triwebb1/crackle/data/audio/fan-calibration-2026-07-25/analysis/esp-8.9-spectrogram.png

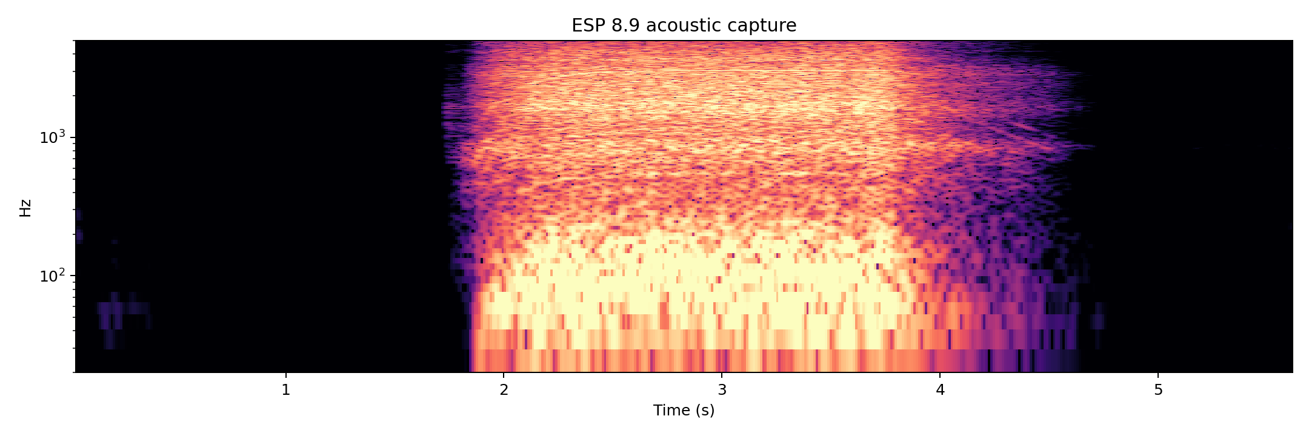
data/audio/fan-calibration-2026-07-25/analysis/esp-8.9-spectrogram.png
