triwebb1/crackle/data/audio/fan-calibration-2026-07-25/analysis/spectrograms.png

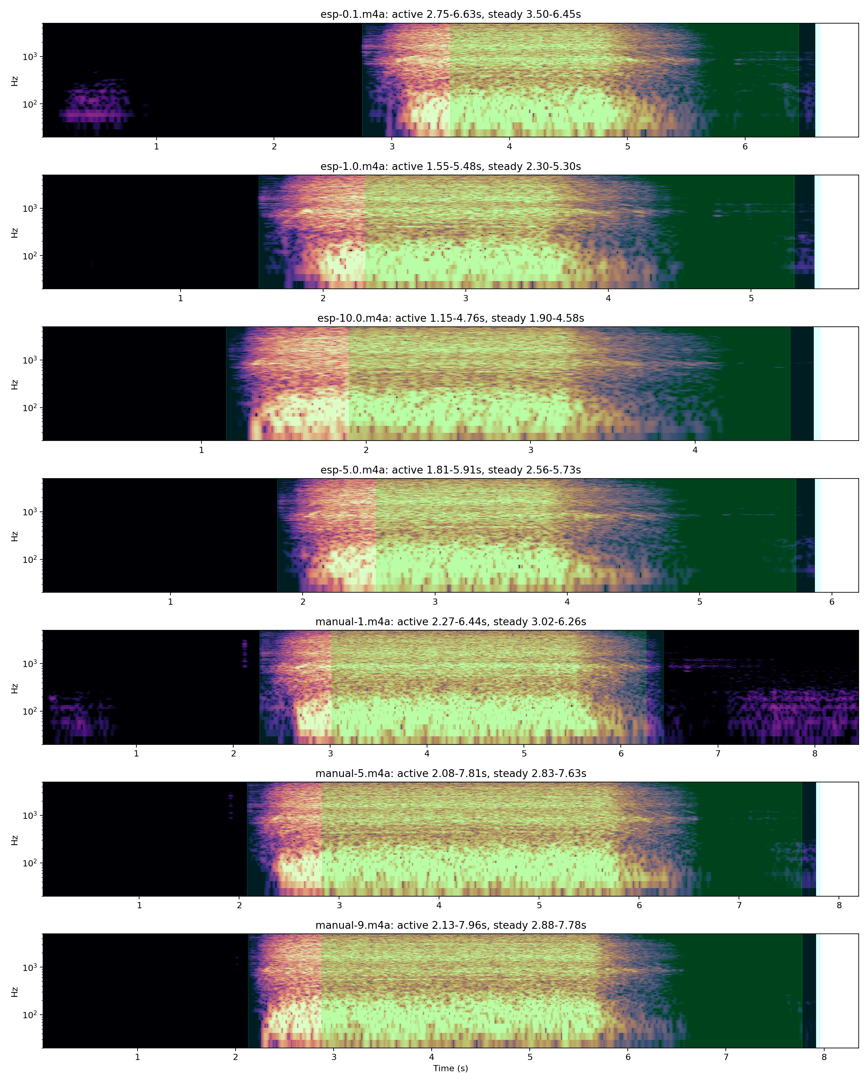
data/audio/fan-calibration-2026-07-25/analysis/spectrograms.png
