triwebb1/crackle/data/audio/fan-calibration-2026-07-25/analysis/fan-tone-calibration.png

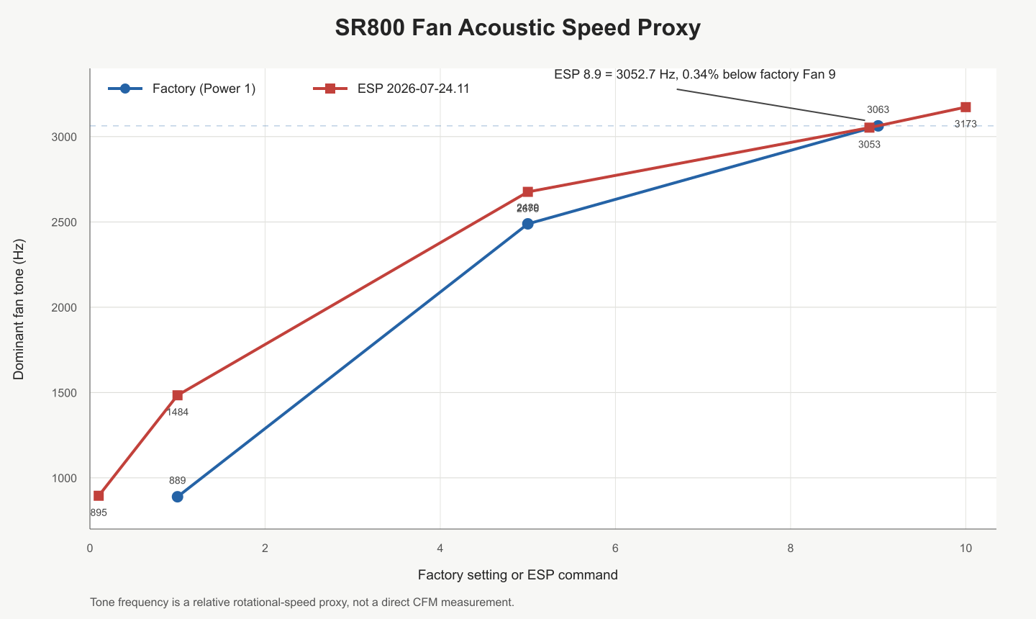
data/audio/fan-calibration-2026-07-25/analysis/fan-tone-calibration.png
