triwebb1/crackle/data/audio/fan-calibration-2026-07-25/analysis/steady-psd-overlays.png

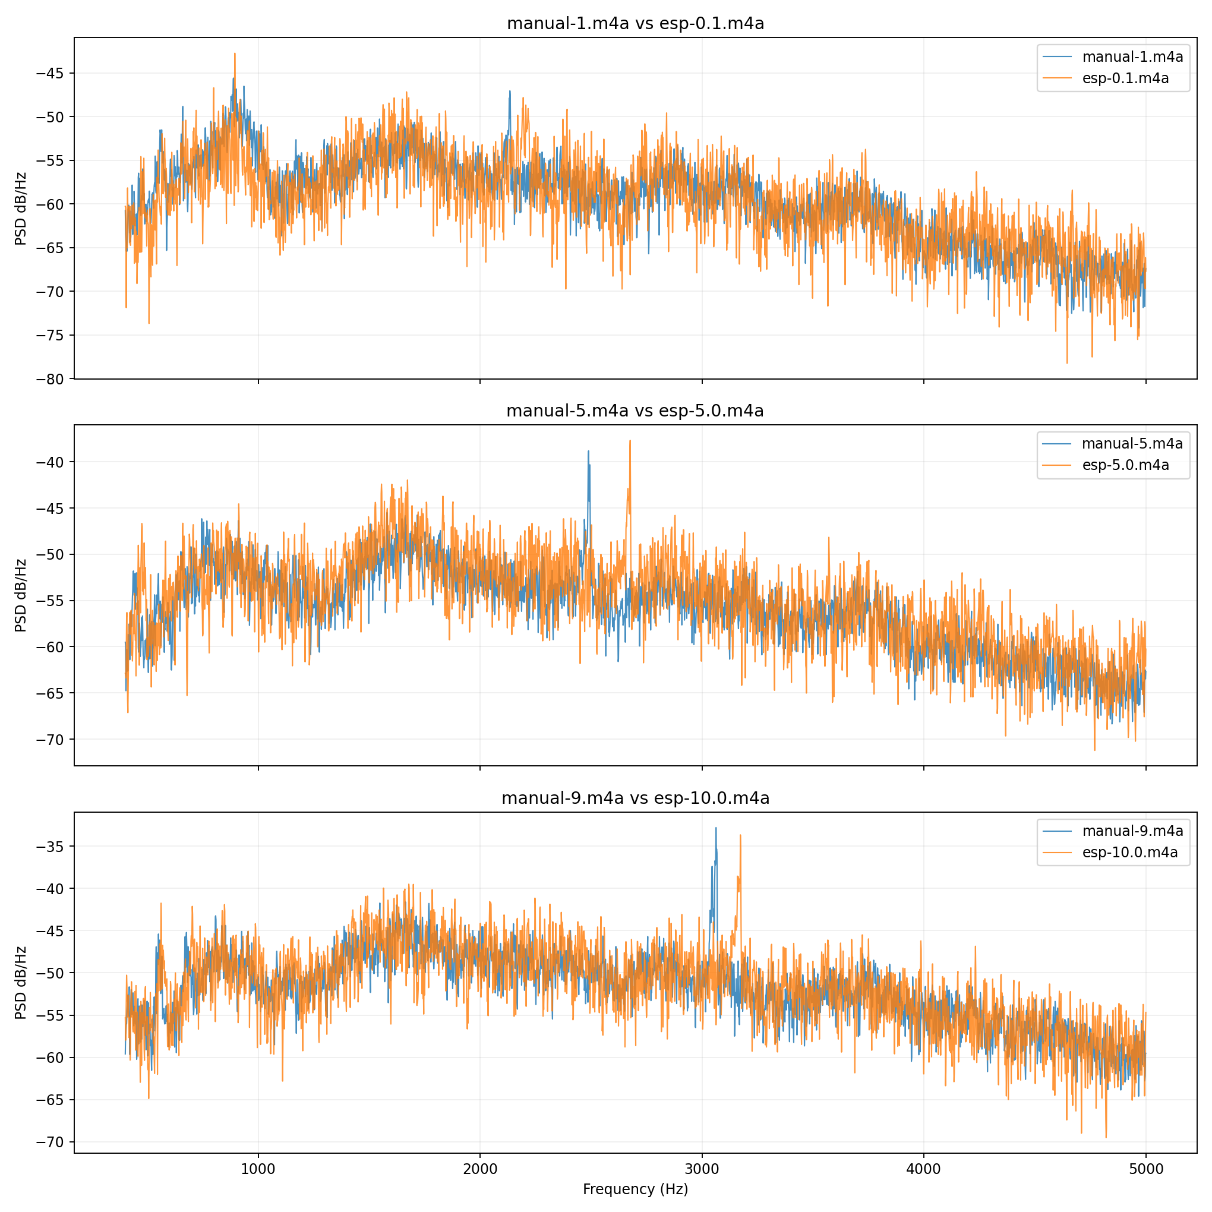
data/audio/fan-calibration-2026-07-25/analysis/steady-psd-overlays.png
