triwebb1/crackle/firmware/crackle/crackle/crackle.ino

#include <Arduino.h>
#include <ESPmDNS.h>
#include <LittleFS.h>
#include <Preferences.h>
#include <SPI.h>
#include <WiFi.h>
#include <time.h>
#include <algorithm>
#include <type_traits>
#include "driver/gpio.h"
#include "driver/temperature_sensor.h"
#include "esp_ota_ops.h"
#include "esp_app_format.h"
#include "esp_partition.h"
#include "esp_http_server.h"
#include "esp_heap_caps.h"
#include "esp_littlefs.h"
#include "esp_cpu.h"
#include "esp_rom_sys.h"
#include "mbedtls/sha256.h"
#include "sr800_actuator.h"
#include "sr800_calibration_settle.h"
#include "sr800_calibration_readiness.h"
#include "sr800_sensor_fault_qualifier.h"
#include "sr800_phase_scheduler.h"
#include "sr800_mcpwm_phase_scheduler.h"
#include "sr800_journey_control.h"
#include "sr800_doc_store.h"
#include "sr800_log_codec.h"
#include "sr800_log_retention.h"
#include "sr800_network_mailbox.h"
#include "sr800_query_args.h"
#include "sr800_network_policy.h"
#include "sr800_network_server.h"
#include "sr800_runtime_contract.h"
#include "sr800_recording_handoff.h"
#include "sr800_storage_health.h"
#include "sr800_volume_budget.h"
#include "crackle_bundle.h"
#include "esp_core_dump.h"
#include "esp_app_desc.h"
#include "sr800_web_pages.h"

// Keep a newly selected OTA image pending until maybeValidateOtaImage() has
// observed real application health. Arduino's default accepts it before setup().
extern "C" bool verifyRollbackLater() {
  return true;
}

namespace {

constexpr char kApName[] = "Crackle";
constexpr char kApPassword[] = "freshroast";
constexpr char kHostName[] = "crackle";
constexpr char kFirmwareVersion[] = "2026-07-26.129";
constexpr char kRoasterModelId[] = "freshroast-sr800";
constexpr char kRoasterDisplayName[] = "FreshRoast SR800";
constexpr char kCaptureRole[] = "crackle_controller";
constexpr char kPreferencesNamespace[] = "sr800-net";
constexpr char kDiagnosticsNamespace[] = "sr800-diag";
constexpr char kRuntimeNamespace[] = "sr800-state";

constexpr gpio_num_t kPins[] = {
    GPIO_NUM_3, GPIO_NUM_4, GPIO_NUM_5, GPIO_NUM_6};
constexpr size_t kChannelCount = sizeof(kPins) / sizeof(kPins[0]);
constexpr size_t kEventCapacity = 512;
constexpr uint8_t kStopNone = 0;
constexpr uint8_t kStopEventLimit = 1;
constexpr uint8_t kStopManual = 2;
constexpr uint32_t kReconnectIntervalMs = 5000;
constexpr uint32_t kApShutdownDelayMs = 15000;
constexpr uint32_t kApRecoveryDelayMs = 15000;
constexpr uint32_t kOtaValidationUptimeMs = 120000;
constexpr gpio_num_t kFanOutputPin = GPIO_NUM_3;
constexpr gpio_num_t kHeaterOutputPin = GPIO_NUM_4;
constexpr gpio_num_t kFactoryFanMonitorPin = GPIO_NUM_5;
constexpr gpio_num_t kZeroCrossPin = GPIO_NUM_6;
constexpr gpio_num_t kMaxDrdyPin = GPIO_NUM_7;
constexpr gpio_num_t kMaxFaultPin = GPIO_NUM_8;
constexpr gpio_num_t kMaxCsPin = GPIO_NUM_9;
constexpr gpio_num_t kMaxMosiPin = GPIO_NUM_10;
constexpr gpio_num_t kMaxMisoPin = GPIO_NUM_11;
constexpr gpio_num_t kMaxSckPin = GPIO_NUM_12;
constexpr uint32_t kMaxSampleIntervalMs = 250;
constexpr uint16_t kNativeHttpPort = 80;
constexpr uint16_t kNativeHttpShadowControlPort = 32768;
constexpr uint32_t kHttpServerRetryIntervalMs = 30000;
uint32_t lastHttpServerStartAttemptMs = 0;
constexpr uint32_t kOtaReceiveNoProgressMs = 30000;
constexpr uint32_t kOtaAdmissionWaitMs = 20000;
constexpr size_t kOtaReceiveChunkBytes = 2048;
constexpr size_t kLiveStatusPayloadBytes = 3072;
// A calibration program can contain 48 steps. The compact/status progress history
// deliberately retains only the latest 12 completed transitions in a rolling window.
constexpr size_t kCalibrationCompletedEventCount = 12;
constexpr size_t kLiveStatusBaseJsonWorstCaseBytes = 1536;
constexpr size_t kLiveStatusCompletedStepWorstCaseBytes = 112;
static_assert(kLiveStatusPayloadBytes >
    kLiveStatusBaseJsonWorstCaseBytes +
        kCalibrationCompletedEventCount * kLiveStatusCompletedStepWorstCaseBytes + 2,
    "live status buffer must hold every retained calibration event");
// Persisted field correction. It applies only to the thermocouple channel;
// cold-junction temperature remains the ambient measurement.
constexpr float kThermocoupleOffsetDefaultC = -3.0f;
float thermocoupleOffsetC = kThermocoupleOffsetDefaultC;
uint64_t stateRevision = sr800::runtime::kFirstRevision;
portMUX_TYPE stateRevisionMux = portMUX_INITIALIZER_UNLOCKED;
uint32_t liveStreamSequence = 0;
uint32_t lastLoopEntryMs = 0;
uint32_t lastLoopGapMs = 0;
uint32_t maximumLoopGapMs = 0;
uint32_t lastThermalArchivePersistMs = 0;
uint32_t maximumThermalArchivePersistMs = 0;
uint32_t thermalArchivePersistCount = 0;

struct ThermalArchivePersistTimer {
  const uint32_t startedMs = millis();

  ~ThermalArchivePersistTimer() {
    const uint32_t durationMs = millis() - startedMs;
    lastThermalArchivePersistMs = durationMs;
    maximumThermalArchivePersistMs =
        std::max(maximumThermalArchivePersistMs, durationMs);
    thermalArchivePersistCount++;
  }
};
sr800::runtime::RestoreLease restoreLease;
constexpr uint32_t kFactoryFanDetectionSpanUs = 50000;
constexpr uint32_t kFactoryFanMaximumGapUs = 25000;
constexpr uint32_t kActuatorPulseWidthUs = 100;
constexpr uint32_t kFanLevelMinimumMilli = 100;
// Design rule: whenever Heat is on, Fan must be 1.0 or higher — on every
// command path, always — so the element is never heating still air. Enforced
// at this command layer (parsers and request sites); the audited actuator core
// keeps its own deeper 0.1-with-heat qualification as the backstop.
constexpr uint32_t kHeatOnFanMinimumMilli = 1000;
constexpr uint32_t kFanLevelMaximumMilli = 10000;
constexpr uint32_t kFanLevelOneDelayUs = 4460;
// Acoustic calibration maps public Fan 10.0 to the old raw 8.9 point.
constexpr uint32_t kFanCappedMaximumDelayUs = 2110;
constexpr uint32_t kFanLevelOneSoftStartUs = 175;
constexpr uint32_t kFanCappedMaximumSoftStartUs = 606;
constexpr uint32_t kHeaterFactoryLevelOneDelayUs = 2820;
constexpr uint32_t kHeaterFactoryLevelNineDelayUs = 800;
constexpr uint32_t kNominalHalfCycleUs = 8333;
constexpr uint32_t kFanRampUs = 500000;
constexpr uint32_t kFanQualificationUs = 500000;
constexpr uint32_t kZeroCrossTimeoutUs = 100000;
constexpr uint32_t kZeroCrossRecoveryGraceUs = 250000;
// Flash/NVS work performed while outputs are off can pause capture callbacks.
// Once that work is complete, allow the six-edge qualifier to catch up before
// issuing the first command instead of making Start depend on a lucky instant.
constexpr uint32_t kActuationStartTimingWaitMs = 250;
constexpr uint32_t kFanTestDefaultMs = 3000;
constexpr uint32_t kFanTestMaximumMs = 3000;
constexpr uint32_t kHeaterProofDefaultMs = 10000;
// Longest heater proof the bounded phase timing log can audit without dropping
// records (sr800_mcpwm_phase_scheduler.h kTimingLogCapacity). Distinct from
// kHeaterProofMaximumMs, which remains the ISR heat lease bound for all modes.
constexpr uint32_t kHeaterProofDiagnosticMaximumMs = 15000;
constexpr uint32_t kHeatDeadlineLoopGraceUs = 500000;
constexpr size_t kCalibrationMaxSteps = 48;
constexpr size_t kCalibrationMaxGridFans = 6;
constexpr size_t kCalibrationMaxGridHeats = 7;
constexpr uint32_t kCalibrationStepMinimumS = 15;
constexpr uint32_t kCalibrationStepMaximumS = 300;
constexpr uint32_t kCalibrationStepDefaultS = 300;
constexpr uint32_t kCalibrationRenewIntervalUs = 5000000;
constexpr uint32_t kCalibrationQualifyStallUs = 10000000;
// Measured air-map data showed chamber air rises 2-3 C/s
// mid-transient with a time constant near a minute: a short settle window
// with a wide band declares "settled" mid-rise and yields time-ordered, not
// setting-ordered, readings. The window range bound implies a slope bound of
// 2*band/window; keep the window long and the band tight.
constexpr uint8_t kCalibrationSettleSecondsDefault = 20;
constexpr uint8_t kCalibrationSettleSecondsMaximum = 30;
constexpr float kCalibrationSettleBandDefaultC = 0.2f;
// A small transition barely moves the probe at first, so the settle window
// alone can fire before the transient has begun. Settled advances are held
// until the step has dwelt at least this long; capped advances are
// unaffected.
constexpr uint32_t kCalibrationMinDwellDefaultS = 20;
constexpr uint32_t kHeaterProofMaximumMs = 30000;
constexpr uint32_t kThermalSafetyFreshnessUs = 1000000;
// The overheat limit, the one thermal safety limit. A fault-free bean-probe
// reading at or above it for the sustain window, while Heat is requested or on,
// latches an overtemperature fault: Heat off at once and locked off until power
// cycle, then a cooldown at Fan 10 that lasts until the reading has stayed below
// the limit for kOvertempCooldownMs (an operator Stop ends it sooner). Roasts end
// near 230 C, so a working probe never reaches 260 C in a normal roast.
// BUILDERS: to roast hotter, raise kOvertempDisableC here and build your own
// image; the web app reads the limit from /api/status.
constexpr float kOvertempDisableC = 260.0f;
constexpr uint32_t kOvertempSustainMs = 1000;
constexpr uint32_t kOvertempCooldownMs = 180000;
constexpr uint32_t kOvertempCooldownFanMilli = 10000;

const sr800::ActuatorConfig kActuatorConfig = {
    kFanOutputPin,
    kHeaterOutputPin,
    kActuatorPulseWidthUs,
    kFanLevelMinimumMilli,
    kFanLevelMaximumMilli,
    kFanLevelOneDelayUs,
    kFanCappedMaximumDelayUs,
    kFanLevelOneSoftStartUs,
    kFanCappedMaximumSoftStartUs,
    kHeaterFactoryLevelOneDelayUs,
    kHeaterFactoryLevelNineDelayUs,
    kFanRampUs,
    kFanQualificationUs,
    kZeroCrossTimeoutUs,
    kZeroCrossRecoveryGraceUs,
    kNominalHalfCycleUs,
    kHeaterProofMaximumMs * 1000U,
    kThermalSafetyFreshnessUs,
    kOvertempCooldownFanMilli,
    kOvertempCooldownMs * 1000U,
};

sr800::Actuator actuator(kActuatorConfig);
sr800::McpwmPhaseScheduler phaseScheduler(
    kFanOutputPin, kHeaterOutputPin, kZeroCrossPin);

struct EdgeEvent {
  uint32_t sequence;
  uint32_t atUs;
  uint32_t precedingGapUs;
  uint8_t changedMask;
  uint8_t levels;
};

DRAM_ATTR volatile EdgeEvent eventBuffer[kEventCapacity];
DRAM_ATTR volatile uint32_t eventCount = 0;
DRAM_ATTR volatile uint32_t lastEventUs = 0;
DRAM_ATTR volatile uint32_t lastEdgeUs[kChannelCount] = {};
DRAM_ATTR volatile uint32_t riseCount[kChannelCount] = {};
DRAM_ATTR volatile uint32_t fallCount[kChannelCount] = {};
DRAM_ATTR volatile uint32_t lastHighUs[kChannelCount] = {};
DRAM_ATTR volatile uint32_t minHighUs[kChannelCount] = {};
DRAM_ATTR volatile uint32_t maxHighUs[kChannelCount] = {};
DRAM_ATTR volatile uint32_t lastLowUs[kChannelCount] = {};
DRAM_ATTR volatile uint32_t minLowUs[kChannelCount] = {};
DRAM_ATTR volatile uint32_t maxLowUs[kChannelCount] = {};
DRAM_ATTR volatile uint8_t lastLevels = 0;
DRAM_ATTR volatile uint8_t seenHighMask = 0;
DRAM_ATTR volatile uint8_t seenLowMask = 0;
DRAM_ATTR volatile bool captureEnabled = false;
DRAM_ATTR volatile bool captureComplete = false;
DRAM_ATTR volatile uint8_t captureStopReason = kStopNone;

DRAM_ATTR volatile bool fanTestActive = false;
DRAM_ATTR volatile uint32_t fanTestEndUs = 0;
DRAM_ATTR volatile uint32_t fanTestLevelMilli = 0;
DRAM_ATTR volatile uint32_t fanTestStartPulseCount = 0;
DRAM_ATTR volatile bool manualConflictLatched = false;

enum class HeaterProofPhase : uint8_t {
  IDLE,
  FAN_QUALIFICATION,
  HEATING,
};

volatile HeaterProofPhase heaterProofPhase = HeaterProofPhase::IDLE;
uint32_t heaterProofDurationMs = 0;
uint32_t heaterProofFanLevelMilli = 0;
uint32_t heaterProofHeatLevelMilli = 0;
uint32_t heaterProofDeadlineUs = 0;
uint32_t heaterProofStartPulseCount = 0;
uint32_t heaterProofQualificationStartedUs = 0;
// Calibration program: one Fan level, a staircase of Heat steps each held for
// a fixed time. Heat runs under renewed 30 s leases so the zero-cross ISR
// bound stays authoritative.
bool calibrationActive = false;
bool calibrationHeatObserved = false;
uint32_t calibrationStepFanMilli[kCalibrationMaxSteps] = {};
uint32_t calibrationHeatMilli[kCalibrationMaxSteps] = {};
size_t calibrationStepCount = 0;
size_t calibrationStepIndex = 0;
// A step boundary whose request met a transient refusal (see serviceCalibrationStepRequest).
bool calibrationStepRequestPending = false;
uint32_t calibrationStepMs = 120000;
uint32_t calibrationMinDwellMs = kCalibrationMinDwellDefaultS * 1000U;
uint32_t calibrationStepEndUs = 0;
bool calibrationStepDeadlineArmed = false;
uint32_t calibrationStepStartedUs = 0;
uint32_t calibrationLastRenewUs = 0;
uint32_t calibrationRenewals = 0;
const char* calibrationEndReason = "none";
const char* calibrationLastAdvance = "none";
struct CalibrationCompletedEvent {
  uint8_t index;
  uint16_t elapsedSec;
  uint8_t fanDeci;
  uint8_t heatDeci;
  float temperatureC;
  const char* outcome;
};
CalibrationCompletedEvent calibrationCompletedEvents[kCalibrationCompletedEventCount] = {};
size_t calibrationCompletedEventUsed = 0;
uint32_t calibrationStableLogId = 0;
uint32_t calibrationStartedEpoch = 0;
uint32_t calibrationCompletedEpoch = 0;

// Manual control: apply any fan/heat under the same renewed 30 s Heat leases
// the calibration program uses, bounded by the 30-minute instruction lease
// below; every always-on protocol (thermal gating, floors, sustained
// overtemperature latch) applies unchanged.

bool manualActive = false;
uint32_t manualFanMilli = 0;
uint32_t manualHeatMilli = 0;
bool manualHeatObserved = false;
uint32_t manualSinceMs = 0;
uint32_t manualLastRenewUs = 0;
// The instruction lease. One rule covers every path that can command the
// machine: an instruction is good for at most 30 minutes, and a NEW
// instruction - the same levels repeated or different ones - resets the clock.
// Manual control is the one path where the instruction comes from a hand rather
// than from a program, so this is where the bound has to be enforced explicitly.
//
// There is deliberately no client-keepalive rule. Making heat conditional on a
// browser staying open and chattering puts the safeguard in the wrong place:
// closing the browser is not an emergency, and the device must not depend on a
// page to stay safe. A manual session survives a closed browser, a dead laptop
// and a dropped link for the full 30 minutes of its instruction, and then stops
// itself.
//
// Expiry stops the active instruction immediately; the actuator remains the
// fail-low authority even if loop service is delayed.
constexpr uint32_t kManualInstructionLeaseMs = 1800000;
uint32_t manualLastInstructionMs = 0;
const char* manualEndReason = "none";
// Adaptive settling: a step advances early once the corrected thermocouple
// first proves the new command has caused a transition, then holds within
// +/- settleBand for settleSeconds consecutive 1 Hz samples.
uint8_t calibrationSettleSeconds = kCalibrationSettleSecondsDefault;
float calibrationSettleBandC = kCalibrationSettleBandDefaultC;
sr800::CalibrationSettleDetector calibrationSettleDetector;
uint32_t calibrationSettleLastMs = 0;

// ---------------------------------------------------------------------------
// The roast executor: Crackle runs the roast, not the browser.
//
// Requirement: once started, a roast continues on the controller after the
// browser that started it closes or disconnects. So a roast is a
// DEVICE-RESIDENT program, a sibling of the calibration program above and built
// out of the same parts: it owns its own 30 s Heat leases and renews them
// itself, it ends on a fault exactly as calibration does, and its recording may
// retain a passive fan-off decay tail.
//
// The 30-minute instruction lease enforced explicitly in the manual block is
// satisfied here BY CONSTRUCTION, and no client-liveness rule of any kind may be
// copied into this path. A running program re-instructs the actuator constantly:
// JOURNEY issues a fresh request every 1 Hz control tick, TIMED issues one at
// every step boundary and renews within a step every 5 s. The longest a program
// can hold Heat without issuing a new actuator request is therefore one renewal
// interval, three orders of magnitude inside the 30-minute bound - see the audit
// note in the README. The program-level outer bound is the runtime envelope
// (2x nominal + 600 s), which is what actually ends a program that will not end
// itself.
//
// A disconnected browser is not a reason to stop; it is the entire point.
//
// Three modes share the framework:
//
//   TIMED   - explicit `F:H:seconds` steps, run on their exact durations. No
//             model, no feedback: what was asked for is what runs.
//   JOURNEY - zones with temperature endpoints, driven at 1 Hz by the ported
//             control law in `sr800_journey_control.*`. Zone advancement is
//             temperature-gated and never time-gated, exactly as the browser's
//             simulation and the cross-language vectors define it.
//   MANUAL  - an operator supplies each Fan/Heat instruction. The controller
//             owns the actuator lease, expiry, and recording exactly as it does
//             for a program; only the next requested levels come from
//             the browser. A lost browser therefore cannot defeat a safety
//             boundary, though it naturally cannot make another adjustment.
// ---------------------------------------------------------------------------
enum class RoastMode : uint8_t { NONE = 0, TIMED, JOURNEY, MANUAL };

constexpr size_t kRoastMaxSteps = 24;
constexpr size_t kActivePlanFixedMaxBytes = 512;
constexpr size_t kActivePlanTimedStepMaxBytes = 64;
constexpr size_t kActivePlanJourneyZoneMaxBytes = 128;
constexpr size_t kActivePlanInitialZoneMaxBytes = 128;
constexpr size_t kActivePlanTimedWorstCaseBytes =
    kActivePlanFixedMaxBytes + kRoastMaxSteps * kActivePlanTimedStepMaxBytes;
constexpr size_t kActivePlanJourneyWorstCaseBytes =
    kActivePlanFixedMaxBytes + sr800::kMaxJourneyZones *
        (kActivePlanJourneyZoneMaxBytes + kActivePlanInitialZoneMaxBytes);
constexpr size_t kActivePlanWorstCaseBytes =
    kActivePlanTimedWorstCaseBytes > kActivePlanJourneyWorstCaseBytes
        ? kActivePlanTimedWorstCaseBytes : kActivePlanJourneyWorstCaseBytes;
static_assert(sr800::kMaxJourneyZones <= 12,
              "Recalculate the active-plan response bound for more zones");
static_assert(kActivePlanWorstCaseBytes <
                  sr800::network::kCommandResponseBytes,
              "Active-plan response must fit the fixed command mailbox");
constexpr uint32_t kRoastStepMinimumS = 1;
constexpr uint32_t kRoastStepMaximumS = 1800;
constexpr uint32_t kRoastZoneMinimumS = 5;
constexpr uint32_t kRoastZoneMaximumS = 1800;
constexpr uint32_t kRoastMassMinimumG = 20;
constexpr uint32_t kRoastMassMaximumG = 2000;
constexpr size_t kRoastNameBytes = 32;
// The control tick. One second is the plan's own resolution, the thermal log's
// interval, and comfortably inside the 30 s Heat lease it renews.
constexpr uint32_t kRoastControlIntervalMs = 1000;
// How long a roast may run feed-forward on a missing or stale reading before the
// dropout is called what it is. The step's own holdover rule covers the gap;
// beyond this the probe is gone and the roast ends with both outputs off.
constexpr uint32_t kRoastHoldoverLimitMs = 30000;
// A thermocouple sample older than this is not a measurement any more. It sits
// deliberately BELOW the actuator's own `thermalSafetyFreshnessUs` (1 s): if the
// roast still called a sample fresh after the actuator had stopped doing so,
// every Heat request in that window would be rejected as stale telemetry and a
// perfectly recoverable poll hiccup would end the roast. Holding over first
// keeps the two gates in the right order.
constexpr uint32_t kRoastSampleFreshnessMs = 900;
constexpr uint16_t kRoastZoneNotAttained = 0xFFFF;

bool roastActive = false;
RoastMode roastMode = RoastMode::NONE;
char roastName[kRoastNameBytes + 1] = {0};
const char* roastEndReason = "none";
uint32_t roastStartedMs = 0;
uint32_t roastStartEpoch = 0;
// A roast's stable identity even when SNTP has not supplied a start epoch.
// Zero means no roast has started during this boot. Each accepted start gets
// the next positive value; failed starts do not consume an id.
uint32_t roastSessionId = 0;
uint32_t roastSessionCounter = 0;
uint32_t roastPlanRevision = 0;
char roastProfileId[65] = {0};
uint32_t roastProfileRevision = 0;
// The operator/program boundary, deliberately separate from the thermal-log
// duration. A recording may continue through a three-minute fan-off decay tail;
// the tail does not belong in a reusable instruction path. Manual roasts are
// bounded to 30 minutes, so uint16 is ample, while the
// saturation keeps the same field well-defined for every roast mode.
uint16_t roastStopSec = 0;
uint32_t roastLastRenewUs = 0;
uint32_t roastRenewals = 0;
uint32_t roastCommandFanMilli = 0;
uint32_t roastCommandHeatMilli = 0;
// MANUAL roast: the same whole-instruction lease as the diagnostic Manual
// page, kept separately so status and end reasons cannot cross-contaminate.
uint32_t roastLastInstructionMs = 0;

// TIMED
uint32_t roastStepFanMilli[kRoastMaxSteps] = {};
uint32_t roastStepHeatMilli[kRoastMaxSteps] = {};
uint32_t roastStepSeconds[kRoastMaxSteps] = {};
size_t roastStepCount = 0;
size_t roastStepIndex = 0;
uint32_t roastStepEndUs = 0;
bool roastStepDeadlineArmed = false;
uint32_t roastStepStartedUs = 0;
uint32_t roastStepDwellRemainingSec = 0;
bool roastHeatObserved = false;

// JOURNEY
sr800::JourneyZone roastZones[sr800::kMaxJourneyZones] = {};
size_t roastZoneCount = 0;
uint16_t roastZoneAttainedSec[sr800::kMaxJourneyZones] = {};
sr800::JourneyControlState roastControlState;
sr800::JourneyCalibration roastCalibration;
double roastAmbientC = 0.0;
double roastBatchMassG = 225.0;
double roastTargetC = 0.0;
double roastCorrectionTotal = 0.0;
double roastIntegral = 0.0;
double roastCommandFan = 0.0;
double roastCommandHeat = 0.0;
uint32_t roastElapsedSec = 0;
uint32_t roastLastTickMs = 0;
sr800::runtime::JourneyHeatContinuity roastHeatContinuity;
bool roastHoldover = false;
bool roastSaturated = false;
// Immutable archive provenance for the currently recorded roast. Full snapshots
// stay in RAM only; codec 2 delta-encodes them into at most 1024 bytes on persist.
sr800::logcodec::PlanProvenance roastArchivePlan = {};
bool roastArchivePlanValid = false;
// The archive format has no truncation marker, so a manual roast whose bounded
// instruction journal is full keeps running every new instruction and simply
// drops the journal entry; this flag reports that the recording's journal is
// incomplete (the journal must never gate the actuator).
bool roastArchiveJournalTruncated = false;
sr800::logcodec::PlanProvenance calibrationArchivePlan = {};
bool calibrationArchivePlanValid = false;
// Device-enforced runtime envelope: 2x the plan's total nominal seconds plus
// ten minutes. Attainment-gated zones mean an unreachable endpoint holds — and
// renews Heat — forever without this bound; browser preflight is advice, not a
// safety boundary.
constexpr uint32_t kRoastEnvelopeMarginSec = 600;
uint32_t roastEnvelopeSec = 0;

uint8_t archivePlanLevel(double level) {
  const long deci = lround(level * 10.0);
  return static_cast<uint8_t>(deci < 0 ? 0 : deci > 100 ? 100 : deci);
}

int16_t archivePlanTemperature(double temperatureC) {
  const long deci = lround(temperatureC * 10.0);
  return static_cast<int16_t>(
      deci < INT16_MIN ? INT16_MIN : deci > INT16_MAX ? INT16_MAX : deci);
}

bool captureCalibrationArchivePlan(const uint32_t* fanMilli,
                                   const uint32_t* heatMilli,
                                   size_t stepCount,
                                   uint32_t maximumStepSeconds,
                                   uint32_t minimumDwellSeconds,
                                   uint8_t settleSeconds,
                                   float settleBandC) {
  calibrationArchivePlan = sr800::logcodec::PlanProvenance{};
  calibrationArchivePlanValid = false;
  if (fanMilli == nullptr || heatMilli == nullptr || stepCount == 0 ||
      stepCount > sr800::logcodec::kMaxCalibrationPlanItems ||
      maximumStepSeconds == 0 || maximumStepSeconds > UINT16_MAX ||
      minimumDwellSeconds > UINT8_MAX) return false;
  calibrationArchivePlan.mode = sr800::logcodec::PlanMode::CALIBRATION;
  calibrationArchivePlan.itemCount = static_cast<uint8_t>(stepCount);
  calibrationArchivePlan.minimumDwellSec =
      static_cast<uint8_t>(minimumDwellSeconds);
  calibrationArchivePlan.settleSeconds = settleSeconds;
  calibrationArchivePlan.settleBandTenthsC = static_cast<uint8_t>(
      lroundf(settleBandC * 10.0f));
  for (size_t index = 0; index < stepCount; ++index) {
    sr800::logcodec::PlanItem& item = calibrationArchivePlan.items[index];
    item.fanDeci = static_cast<uint8_t>((fanMilli[index] + 50U) / 100U);
    item.heatDeci = static_cast<uint8_t>((heatMilli[index] + 50U) / 100U);
    item.durationSec = static_cast<uint16_t>(maximumStepSeconds);
  }
  uint8_t proof[sr800::logcodec::kMaxPlanEnvelopeBytes];
  calibrationArchivePlanValid = sr800::logcodec::encodePlanProvenance(
      calibrationArchivePlan, proof, sizeof(proof)) > 0;
  return calibrationArchivePlanValid;
}
void captureInitialRoastArchivePlan() {
  roastArchivePlan = sr800::logcodec::PlanProvenance{};
  roastArchivePlanValid = false;
  roastArchiveJournalTruncated = false;
  roastArchivePlan.mode =
      roastMode == RoastMode::TIMED ? sr800::logcodec::PlanMode::TIMED :
      roastMode == RoastMode::JOURNEY ? sr800::logcodec::PlanMode::JOURNEY :
      sr800::logcodec::PlanMode::MANUAL;
  if (roastMode == RoastMode::TIMED) {
    roastArchivePlan.itemCount = static_cast<uint8_t>(roastStepCount);
    for (size_t index = 0; index < roastStepCount; ++index) {
      sr800::logcodec::PlanItem& item = roastArchivePlan.items[index];
      item.fanDeci = static_cast<uint8_t>(
          (roastStepFanMilli[index] + 50U) / 100U);
      item.heatDeci = static_cast<uint8_t>(
          (roastStepHeatMilli[index] + 50U) / 100U);
      item.durationSec = static_cast<uint16_t>(roastStepSeconds[index]);
    }
  } else if (roastMode == RoastMode::JOURNEY) {
    roastArchivePlan.itemCount = static_cast<uint8_t>(roastZoneCount);
    for (size_t index = 0; index < roastZoneCount; ++index) {
      const sr800::JourneyZone& zone = roastZones[index];
      sr800::logcodec::PlanItem& item = roastArchivePlan.items[index];
      item.startDeci = archivePlanTemperature(zone.startC);
      item.endDeci = archivePlanTemperature(zone.endC);
      item.durationSec = static_cast<uint16_t>(lround(zone.durationSec));
      item.fanMinDeci = archivePlanLevel(zone.fanMin);
      item.fanMaxDeci = archivePlanLevel(zone.fanMax);
      item.heatMinDeci = archivePlanLevel(zone.heatMin);
      item.heatMaxDeci = archivePlanLevel(zone.heatMax);
    }
  } else if (roastMode == RoastMode::MANUAL) {
    roastArchivePlan.itemCount = 1;
    roastArchivePlan.items[0].fanDeci = static_cast<uint8_t>(
        (roastCommandFanMilli + 50U) / 100U);
    roastArchivePlan.items[0].heatDeci = static_cast<uint8_t>(
        (roastCommandHeatMilli + 50U) / 100U);
  } else {
    return;
  }
  uint8_t proof[sr800::logcodec::kMaxPlanEnvelopeBytes];
  roastArchivePlanValid = sr800::logcodec::encodePlanProvenance(
      roastArchivePlan, proof, sizeof(proof)) > 0;
}

bool stageRoastArchivePlanChange(const sr800::JourneyZone* zones,
                                 size_t zoneCount,
                                 uint32_t elapsedSec,
                                 uint32_t planRevision) {
  if (!roastArchivePlanValid ||
      roastArchivePlan.mode != sr800::logcodec::PlanMode::JOURNEY ||
      roastArchivePlan.journalCount >=
          sr800::logcodec::kMaxPlanJournalEvents ||
      zoneCount == 0 || zoneCount > sr800::kMaxJourneyZones ||
      elapsedSec > UINT16_MAX) {
    return false;
  }
  sr800::logcodec::PlanJournalEvent& event =
      roastArchivePlan.journal[roastArchivePlan.journalCount];
  event = sr800::logcodec::PlanJournalEvent{};
  event.elapsedSec = static_cast<uint16_t>(elapsedSec);
  event.planRevision = planRevision;
  event.itemCount = static_cast<uint8_t>(zoneCount);
  for (size_t index = 0; index < zoneCount; ++index) {
    sr800::logcodec::PlanItem& item = event.items[index];
    item.startDeci = archivePlanTemperature(zones[index].startC);
    item.endDeci = archivePlanTemperature(zones[index].endC);
    item.durationSec = static_cast<uint16_t>(lround(zones[index].durationSec));
    item.fanMinDeci = archivePlanLevel(zones[index].fanMin);
    item.fanMaxDeci = archivePlanLevel(zones[index].fanMax);
    item.heatMinDeci = archivePlanLevel(zones[index].heatMin);
    item.heatMaxDeci = archivePlanLevel(zones[index].heatMax);
  }
  roastArchivePlan.journalCount++;
  uint8_t proof[sr800::logcodec::kMaxPlanEnvelopeBytes];
  if (sr800::logcodec::encodePlanProvenance(
          roastArchivePlan, proof, sizeof(proof)) == 0) {
    roastArchivePlan.journalCount--;
    return false;
  }
  return true;
}

bool stageTimedRoastArchiveChange(size_t stepIndex,
                                  uint32_t fanMilli,
                                  uint32_t heatMilli,
                                  uint32_t durationSec,
                                  uint32_t elapsedSec,
                                  uint32_t planRevision) {
  if (!roastArchivePlanValid || roastArchivePlan.mode != sr800::logcodec::PlanMode::TIMED ||
      roastArchivePlan.journalCount >= sr800::logcodec::kMaxPlanJournalEvents ||
      stepIndex >= kRoastMaxSteps || elapsedSec > UINT16_MAX || durationSec == 0 || durationSec > UINT16_MAX) return false;
  sr800::logcodec::PlanJournalEvent& event = roastArchivePlan.journal[roastArchivePlan.journalCount];
  event = sr800::logcodec::PlanJournalEvent{};
  event.elapsedSec = static_cast<uint16_t>(elapsedSec);
  event.planRevision = planRevision;
  event.itemIndex = static_cast<uint8_t>(stepIndex);
  event.itemCount = 1;
  event.items[0].fanDeci = static_cast<uint8_t>((fanMilli + 50U) / 100U);
  event.items[0].heatDeci = static_cast<uint8_t>((heatMilli + 50U) / 100U);
  event.items[0].durationSec = static_cast<uint16_t>(durationSec);
  roastArchivePlan.journalCount++;
  uint8_t proof[sr800::logcodec::kMaxPlanEnvelopeBytes];
  if (sr800::logcodec::encodePlanProvenance(roastArchivePlan, proof, sizeof(proof)) == 0) {
    roastArchivePlan.journalCount--;
    return false;
  }
  return true;
}

bool canStageManualRoastArchiveChange(uint32_t elapsedSec) {
  return roastArchivePlanValid &&
      roastArchivePlan.mode == sr800::logcodec::PlanMode::MANUAL &&
      roastArchivePlan.journalCount < sr800::logcodec::kMaxPlanJournalEvents &&
      elapsedSec <= UINT16_MAX;
}

bool stageManualRoastArchiveChange(uint32_t elapsedSec,
                                   uint32_t planRevision,
                                   uint32_t requestedFanMilli,
                                   uint32_t requestedHeatMilli,
                                   uint32_t effectiveFanMilli,
                                   uint32_t effectiveHeatMilli) {
  if (!canStageManualRoastArchiveChange(elapsedSec)) return false;
  sr800::logcodec::PlanJournalEvent& event =
      roastArchivePlan.journal[roastArchivePlan.journalCount];
  event = sr800::logcodec::PlanJournalEvent{};
  event.elapsedSec = static_cast<uint16_t>(elapsedSec);
  event.planRevision = planRevision;
  event.itemCount = 1;
  event.items[0].fanDeci = static_cast<uint8_t>((requestedFanMilli + 50U) / 100U);
  event.items[0].heatDeci = static_cast<uint8_t>((requestedHeatMilli + 50U) / 100U);
  event.items[0].fanMinDeci = static_cast<uint8_t>((effectiveFanMilli + 50U) / 100U);
  event.items[0].heatMinDeci = static_cast<uint8_t>((effectiveHeatMilli + 50U) / 100U);
  roastArchivePlan.journalCount++;
  uint8_t proof[sr800::logcodec::kMaxPlanEnvelopeBytes];
  if (sr800::logcodec::encodePlanProvenance(
          roastArchivePlan, proof, sizeof(proof)) == 0) {
    roastArchivePlan.journalCount--;
    return false;
  }
  return true;
}

const char* roastModeName(RoastMode mode) {
  switch (mode) {
    case RoastMode::TIMED: return "timed";
    case RoastMode::JOURNEY: return "journey";
    case RoastMode::MANUAL: return "manual";
    default: return "none";
  }
}

// Stable one-byte archive codes. Zero is the old-v3 reserved-byte value and
// therefore means "not recorded"; values are never inferred for older files.
uint8_t roastEndReasonCode(const char* reason) {
  if (reason == nullptr || strcmp(reason, "none") == 0) return 0;
  if (strcmp(reason, "stopped") == 0) return 1;
  if (strcmp(reason, "completed") == 0) return 2;
  if (strcmp(reason, "fault") == 0) return 3;
  if (strcmp(reason, "instruction_expired") == 0) return 4;
  if (strcmp(reason, "renewal_rejected") == 0) return 5;
  if (strcmp(reason, "qualification_stalled") == 0) return 6;
  if (strcmp(reason, "sensor_lost") == 0) return 7;
  if (strcmp(reason, "command_rejected") == 0) return 8;
  if (strcmp(reason, "envelope_timeout") == 0) return 9;
  if (strcmp(reason, "step_rejected") == 0) return 10;
  if (strcmp(reason, "telemetry_stale") == 0) return 11;
  if (strcmp(reason, "heat_lease_expired") == 0) return 12;
  return 0;
}

const char* roastEndReasonFromCode(uint8_t code) {
  switch (code) {
    case 1: return "stopped";
    case 2: return "completed";
    case 3: return "fault";
    case 4: return "instruction_expired";
    case 5: return "renewal_rejected";
    case 6: return "qualification_stalled";
    case 7: return "sensor_lost";
    case 8: return "command_rejected";
    case 9: return "envelope_timeout";
    case 10: return "step_rejected";
    case 11: return "telemetry_stale";
    case 12: return "heat_lease_expired";
    default: return nullptr;
  }
}

// Capture the end while the roast clock still belongs to the active program.
// Every exit path uses this helper so status, Stop acknowledgements and the
// eventual archive header all report the same boundary and reason.
void markRoastEnded(const char* reason) {
  const uint32_t elapsed = (millis() - roastStartedMs) / 1000U;
  roastElapsedSec = elapsed;
  roastStopSec = elapsed > UINT16_MAX ? UINT16_MAX
                                      : static_cast<uint16_t>(elapsed);
  roastActive = false;
  roastEndReason = reason;
}

// A solved level in 0.0 through 10.0 as the actuator's milli-units, with the
// same drive-minimum treatment every other request path applies.
uint32_t roastLevelToMilli(double level) {
  if (!(level > 0.0)) return 0;
  double bounded = level < 0.1 ? 0.1 : level;
  if (bounded > 10.0) bounded = 10.0;
  uint32_t milli = static_cast<uint32_t>(lround(bounded * 1000.0));
  if (milli < kFanLevelMinimumMilli) milli = kFanLevelMinimumMilli;
  if (milli > kFanLevelMaximumMilli) milli = kFanLevelMaximumMilli;
  return milli;
}

// The universal heat-on Fan floor (see kHeatOnFanMinimumMilli): a commanded pair
// carrying Heat is lifted — never refused — to Fan 1.0 when its fan is lower.
uint32_t heatOnFanFloorMilli(uint32_t fanMilli, uint32_t heatMilli) {
  return heatMilli > 0 && fanMilli < kHeatOnFanMinimumMilli
             ? kHeatOnFanMinimumMilli
             : fanMilli;
}

void resetCalibrationSettle() {
  calibrationSettleDetector.reset(
      calibrationSettleSeconds, calibrationSettleBandC);
  calibrationSettleLastMs = 0;
}

bool calibrationStepSettled() {
  return calibrationSettleDetector.settled();
}

// Calibration thermal log: 1 Hz corrected-temperature samples from program or
// proof start through command completion and passive decay. Loop-task only; no ISR access.
//
// The capacity is defined in the shared volume budget rather than here, because
// it is one of the two terms that decide how large a single persist can be —
// and therefore how much free space a document write has to leave behind. The
// two subsystems get one number or they drift apart again.
constexpr uint32_t kThermalLogCapacity = sr800::volume::kMaxRecordingSamples;
constexpr uint32_t kThermalLogIntervalMs = 1000;
constexpr uint32_t kCompactRoastLogIntervalMs = 10000;
struct ThermalSample {
  uint32_t tMs;
  int16_t thermocoupleDeci;
  int16_t coldJunctionDeci;
  uint16_t fanMilli;
  uint16_t heatMilli;
};
// The RAM log uses the v4 archive's honest 0.1 C precision. Keeping a 12-byte
// row matters for the 4,800-sample capacity, but centi-degrees in an int16 wrap
// at 327.68 C — below the 400 C safety latch. Deci-degrees preserve the full
// plausible roast/calibration range without spending more RAM. INT16_MIN is
// reserved as the missing-channel sentinel.
static_assert(sizeof(ThermalSample) == sr800::logcodec::kRawSampleBytes,
              "the in-flight sample must stay inside the 12-byte RAM budget");
ThermalSample* thermalLog = nullptr;

// The codec's already-quantized view. Persisting this directly avoids treating
// a deci-degree value as a legacy raw centi-degree value.
sr800::logcodec::Sample toCodecSample(const ThermalSample& sample) {
  sr800::logcodec::Sample encoded = {};
  encoded.tMs = sample.tMs;
  encoded.thermocoupleValid = sample.thermocoupleDeci != INT16_MIN;
  encoded.coldJunctionValid = sample.coldJunctionDeci != INT16_MIN;
  encoded.thermocoupleDeci = encoded.thermocoupleValid
      ? sample.thermocoupleDeci : 0;
  encoded.coldJunctionDeci = encoded.coldJunctionValid
      ? sample.coldJunctionDeci : 0;
  encoded.fanDeci = sr800::logcodec::milliToDeci(sample.fanMilli);
  encoded.heatDeci = sr800::logcodec::milliToDeci(sample.heatMilli);
  return encoded;
}
uint32_t thermalLogCount = 0;
uint32_t thermalLogStartMs = 0;
uint32_t thermalLogLastSampleMs = 0;
uint32_t thermalLogIntervalMs = kThermalLogIntervalMs;
float thermalLogThermocoupleOffsetC = kThermocoupleOffsetDefaultC;
bool thermalLogActive = false;
// Core 1 owns capture state and closes the recording. Core 0 may only claim a
// frozen recording for persistence; the handoff is protected by this mux.
portMUX_TYPE thermalLogMux = portMUX_INITIALIZER_UNLOCKED;
bool thermalLogPersistenceClaimed = false;
// False whenever the recording policy for this source did not complete. Roast
// programs normally retain a passive decay tail; a manual roast deliberately
// completes at the operator's Stop boundary. The archive never guesses why an
// interrupted capture ended.
bool thermalLogPassiveTailComplete = true;

// On-device log archive: every completed thermal log persists to the 896 KB
// LittleFS partition so Crackle can list, fetch, and select historical runs
// without any third-party export step. Flash writes stall the MCPWM capture
// callbacks (the cache-blackout failure mode behind the coast policy), so a
// persist may only ever run while the actuator is fully idle: before a start
// request is issued, or from the idle-finalize watcher in the service loop.
enum class ThermalLogSource : uint8_t {
  NONE = 0, PROOF, CALIBRATION,
  MANUAL,  // Legacy archive tag; current Manual Controls does not record.
  ROAST
};
constexpr char kLogArchiveDir[] = "/logs";
constexpr char kLogArchiveTempPath[] = "/logs/pending.tmp";
constexpr uint8_t kLogPersistMaxAttempts = 3;
constexpr uint32_t kLogArchiveMagic = 0x4C4B5243;  // "CRKL"
// Version 4 adds immutable producer identity. This development build has no
// pre-existing data to preserve: only v4 is accepted, and older/unprovenanced
// files are quarantined by the listing endpoint.
constexpr uint16_t kLogArchiveVersion = 4;
constexpr size_t kLogArchiveHeaderV1Bytes = 32;
constexpr size_t kLogArchiveHeaderV2Bytes = 92;
constexpr uint32_t kLogArchiveMinSamples = 30;
// The archive's working reserve, and the document store's 507 floor, come from
// the same derivation — see sr800_volume_budget.h. Retention sweeps to keep
// this much free; a document write is refused unless it leaves this much PLUS
// the largest recording a persist could present, which is what makes "a
// metadata write never forces retention" arithmetic rather than a hope.
constexpr uint32_t kLogArchiveReserveBytes = sr800::volume::kLogArchiveReserveBytes;
// How long everything must stay idle before a recording is closed. This is the
// length of the PASSIVE DECAY TAIL the recording captures, and it is chosen
// against what that tail is for.
//
// The tail is the loss/tau fit's raw material, but not all of it is usable. The
// first ~30 s after the fan stops is HEAT-SOAK REBOUND: the element and the
// chamber wall are still hotter than the bean mass, and with no airflow to
// carry it away that stored heat pushes the probe back UP. It is a real
// measurement of a real thing, and it is emphatically not exponential decay —
// fitting a loss coefficient through it reads the rebound as negative loss and
// biases tau long. So the window has to clear the rebound and then keep going
// long enough to have a clean stretch worth regressing: ~3 minutes gives ~30 s
// of rebound and ~150 s of clean decay, which at deci-degree resolution is
// ~150 distinguishable points down a curve that falls a fraction of a degree
// per second. (At whole-degree resolution it would have been ~15 flats, which
// is half of why the archive now stores tenths.)
//
// It was 10 minutes, which was not more information — it was ~600 samples of
// asymptote, ~40% of a typical recording's bytes, describing the last few
// degrees of approach to room temperature that no fit is sensitive to.
// The tail closes on time alone. A temperature-based early exit (<100 C
// sustained 60 s) was tried and withdrawn: after outputs stop, the fan-off
// tail usually BEGINS below 100 C, so that rule closed recordings at
// the 60 s mark — ~30 s of heat-soak rebound plus ~30 s of decay — gutting
// the clean-slope window the 3-minute cap exists to capture. The rule could
// only ever shorten the tail when shortening hurt the fit, and never fired
// when the chamber was hot (the cap wins there). Cost of the full window over
// the early exit: ~600 bytes per recording.
constexpr uint32_t kLogIdleFinalizeMs = 3U * 60U * 1000U;
struct LogArchiveHeader {
  // --- version 1: the first 32 bytes, and their layout is frozen ---
  uint32_t magic;
  uint16_t version;
  uint8_t source;
  uint8_t reserved;
  uint32_t logId;
  uint32_t boot;
  uint32_t startEpoch;  // Unix seconds at first sample; 0 = clock never synced
  uint32_t durationMs;
  uint32_t sampleCount;
  uint32_t intervalMs;
  // --- version 2 additions ---
  char name[kRoastNameBytes];  // roast name, NOT null-terminated when full
  uint8_t zoneCount;           // 0 for a timed roast or a non-roast log
  // RoastMode on newly written roast logs; 0 on older files and non-roast
  // logs. This deliberately consumes the frozen v2 reserved byte rather than
  // preserving the former v3 byte offsets inside the v4 header. The serving
  // new browser can distinguish manual from timed recordings without guessing
  // from the actuator curve.
  uint8_t roastMode;
  uint16_t batchMassG;         // 0 = not a roast / mass unknown
  uint16_t zoneAttainedSec[sr800::kMaxJourneyZones];  // 0xFFFF = not attained
  // --- version 3 additions ---
  uint32_t encodedBytes;  // payload length on disk, whatever the codec
  uint32_t crc32;         // v4 metadata, provenance, and payload integrity
  uint8_t codec;          // see sr800_log_codec.h; 0 = the raw v2 layout
  // Former v3 reserved bytes. Stop seconds are little-endian at 101..102;
  // reason is the stable code above at 103. Old v3 files contain zeroes.
  uint8_t roastStopSecBytes[2];
  uint8_t roastEndReason;
  // --- version 4: immutable producer identity, covered by the file CRC ---
  char sourceDeviceId[sr800::logcodec::kArchiveDeviceIdBytes];
  char sourceModelId[sr800::logcodec::kArchiveModelIdBytes];
  char sourceDisplayName[sr800::logcodec::kArchiveDisplayNameBytes];
  char sourceFirmwareVersion[sr800::logcodec::kArchiveFirmwareVersionBytes];
  uint32_t originLogId;
  uint8_t provenanceFlags;
  uint8_t provenanceReserved[3];
  uint32_t provenanceCrc32;
};
static_assert(sizeof(LogArchiveHeader) == sr800::volume::kLogArchiveHeaderBytes,
              "the archive header layout is a wire format, and the volume "
              "budget sizes the worst-case recording from it");
constexpr size_t kLogArchiveHeaderV3Bytes = sr800::logcodec::kArchiveHeaderV3Bytes;
constexpr size_t kLogArchiveHeaderV4Bytes = sizeof(LogArchiveHeader);
// `sr800_log_codec.h` validates an UPLOADED archive file by byte offset — it is
// a wire format, and it has to be checkable on a host where this struct's
// padding is the host compiler's business. These assertions are the joint: the
// struct the device writes and the offsets the validator reads cannot drift
// apart without failing the build.
static_assert(kLogArchiveMagic == sr800::logcodec::kArchiveMagic, "magic");
static_assert(kLogArchiveVersion <= sr800::logcodec::kArchiveVersionMax,
              "the validator must know every version this firmware writes");
static_assert(kLogArchiveHeaderV1Bytes == sr800::logcodec::kArchiveHeaderV1Bytes,
              "v1 header size");
static_assert(kLogArchiveHeaderV2Bytes == sr800::logcodec::kArchiveHeaderV2Bytes,
              "v2 header size");
static_assert(kLogArchiveHeaderV3Bytes == sr800::logcodec::kArchiveHeaderV3Bytes,
              "v3 header size");
static_assert(kLogArchiveHeaderV4Bytes == sr800::logcodec::kArchiveHeaderV4Bytes,
              "v4 header size");
static_assert(sr800::kMaxJourneyZones == sr800::logcodec::kArchiveMaxZones,
              "zone maximum");
static_assert(offsetof(LogArchiveHeader, magic) ==
              sr800::logcodec::kArchiveOffsetMagic, "magic offset");
static_assert(offsetof(LogArchiveHeader, version) ==
              sr800::logcodec::kArchiveOffsetVersion, "version offset");
static_assert(offsetof(LogArchiveHeader, source) ==
              sr800::logcodec::kArchiveOffsetSource, "source offset");
static_assert(offsetof(LogArchiveHeader, logId) ==
              sr800::logcodec::kArchiveOffsetLogId, "logId offset");
static_assert(offsetof(LogArchiveHeader, sampleCount) ==
              sr800::logcodec::kArchiveOffsetSampleCount, "sampleCount offset");
static_assert(offsetof(LogArchiveHeader, zoneCount) ==
               sr800::logcodec::kArchiveOffsetZoneCount, "zoneCount offset");
static_assert(offsetof(LogArchiveHeader, roastMode) == 65,
              "roast mode occupies the v2 reserved byte");
static_assert(offsetof(LogArchiveHeader, encodedBytes) ==
              sr800::logcodec::kArchiveOffsetEncodedBytes,
              "encodedBytes offset");
static_assert(offsetof(LogArchiveHeader, crc32) ==
              sr800::logcodec::kArchiveOffsetCrc32, "crc32 offset");
static_assert(offsetof(LogArchiveHeader, codec) ==
              sr800::logcodec::kArchiveOffsetCodec, "codec offset");
static_assert(offsetof(LogArchiveHeader, roastStopSecBytes) ==
                  sr800::logcodec::kArchiveOffsetRoastStopSec,
              "roast stop seconds occupy v3 reserved bytes 101..102");
static_assert(offsetof(LogArchiveHeader, roastEndReason) ==
                  sr800::logcodec::kArchiveOffsetRoastEndReason,
              "roast end reason occupies v3 reserved byte 103");
static_assert(offsetof(LogArchiveHeader, sourceDeviceId) ==
                  sr800::logcodec::kArchiveOffsetSourceDeviceId,
              "source device id offset");
static_assert(offsetof(LogArchiveHeader, sourceModelId) ==
                  sr800::logcodec::kArchiveOffsetSourceModelId,
              "source model id offset");
static_assert(offsetof(LogArchiveHeader, sourceDisplayName) ==
                  sr800::logcodec::kArchiveOffsetSourceDisplayName,
              "source display name offset");
static_assert(offsetof(LogArchiveHeader, sourceFirmwareVersion) ==
                  sr800::logcodec::kArchiveOffsetSourceFirmwareVersion,
              "source firmware version offset");
static_assert(offsetof(LogArchiveHeader, originLogId) ==
                  sr800::logcodec::kArchiveOffsetOriginLogId,
              "origin log id offset");
static_assert(offsetof(LogArchiveHeader, provenanceFlags) ==
                  sr800::logcodec::kArchiveOffsetProvenanceFlags,
              "provenance flags offset");
static_assert(offsetof(LogArchiveHeader, provenanceReserved) ==
                  sr800::logcodec::kArchiveOffsetThermocoupleOffsetCenti,
              "thermocouple offset metadata starts at byte 213");
static_assert(offsetof(LogArchiveHeader, provenanceCrc32) ==
                  sr800::logcodec::kArchiveOffsetProvenanceCrc32,
              "provenance checksum offset");
static_assert(sizeof(ThermalSample) == sr800::logcodec::kRawSampleBytes,
              "the v1/v2 payload stride the validator assumes");

void formatStableDeviceId(char* out, size_t capacity) {
  snprintf(out, capacity, "esp32-%012llx",
           static_cast<unsigned long long>(ESP.getEfuseMac() & 0xFFFFFFFFFFFFULL));
}

void fillArchiveProvenance(LogArchiveHeader& header) {
  formatStableDeviceId(header.sourceDeviceId, sizeof(header.sourceDeviceId));
  snprintf(header.sourceModelId, sizeof(header.sourceModelId), "%s",
           kRoasterModelId);
  snprintf(header.sourceDisplayName, sizeof(header.sourceDisplayName), "%s",
           kRoasterDisplayName);
  snprintf(header.sourceFirmwareVersion, sizeof(header.sourceFirmwareVersion),
           "%s", kFirmwareVersion);
  header.originLogId = header.logId;
  header.provenanceFlags = thermalLogPassiveTailComplete
      ? 0 : sr800::logcodec::kArchivePassiveTailIncomplete;
  const long offsetCentiLong = lroundf(thermalLogThermocoupleOffsetC * 100.0f);
  const int16_t offsetCenti = static_cast<int16_t>(
      offsetCentiLong < sr800::logcodec::kArchiveThermocoupleOffsetMinimumCenti
          ? sr800::logcodec::kArchiveThermocoupleOffsetMinimumCenti
          : offsetCentiLong > sr800::logcodec::kArchiveThermocoupleOffsetMaximumCenti
              ? sr800::logcodec::kArchiveThermocoupleOffsetMaximumCenti
              : offsetCentiLong);
  const uint16_t offsetCentiBits = static_cast<uint16_t>(offsetCenti);
  header.provenanceReserved[0] = static_cast<uint8_t>(offsetCentiBits & 0xFFU);
  header.provenanceReserved[1] = static_cast<uint8_t>((offsetCentiBits >> 8) & 0xFFU);
  header.provenanceReserved[2] = sr800::logcodec::kArchiveThermocoupleOffsetPresent;
  // Physical firmware never sets kArchiveProvenanceSimulated.
  const uint8_t* bytes = reinterpret_cast<const uint8_t*>(&header);
  header.provenanceCrc32 = sr800::logcodec::crc32Finish(
      sr800::logcodec::crc32Update(
          sr800::logcodec::kCrc32Init,
          bytes + sr800::logcodec::kArchiveOffsetSourceDeviceId,
          sr800::logcodec::kArchiveOffsetProvenanceCrc32 -
              sr800::logcodec::kArchiveOffsetSourceDeviceId));
}

bool archiveThermocoupleOffset(const LogArchiveHeader& header,
                               int16_t& offsetCenti) {
  if ((header.provenanceReserved[2] &
       sr800::logcodec::kArchiveThermocoupleOffsetPresent) == 0) return false;
  const uint16_t raw = static_cast<uint16_t>(header.provenanceReserved[0]) |
      (static_cast<uint16_t>(header.provenanceReserved[1]) << 8);
  offsetCenti = static_cast<int16_t>(raw);
  return offsetCenti >= sr800::logcodec::kArchiveThermocoupleOffsetMinimumCenti &&
      offsetCenti <= sr800::logcodec::kArchiveThermocoupleOffsetMaximumCenti;
}

uint32_t archiveIntegrityCrcBegin(const LogArchiveHeader& header) {
  const uint8_t* bytes = reinterpret_cast<const uint8_t*>(&header);
  uint32_t crc = sr800::logcodec::kCrc32Init;
  crc = sr800::logcodec::crc32Update(
      crc, bytes, sr800::logcodec::kArchiveOffsetCrc32);
  return sr800::logcodec::crc32Update(
      crc, bytes + sr800::logcodec::kArchiveOffsetCodec,
      sizeof(header) - sr800::logcodec::kArchiveOffsetCodec);
}
ThermalLogSource thermalLogSource = ThermalLogSource::NONE;
bool thermalLogUnsaved = false;
uint8_t thermalLogPersistAttempts = 0;
uint32_t thermalLogPersistNotBeforeMs = 0;
// Meaningful logs that could not be persisted and are gone. Surfaced in
// /api/status so a sick filesystem is a visible fact, not a silent one.
uint32_t logArchiveLostLogs = 0;
// True when the archive volume failed to mount but was previously initialized:
// formatting would destroy stored logs, so it waits for an explicit command.
bool logArchiveNeedsFormat = false;
bool logArchiveMounted = false;
enum class StorageFailureStage : uint8_t {
  NONE = 0,
  PARTITION_MISSING,
  LAYOUT_MISMATCH,
  MARKER_WRITE,
  MOUNT,
  FORMAT,
  PROBE_DEST_OPEN,
  PROBE_DEST_WRITE,
  PROBE_TEMP_OPEN,
  PROBE_TEMP_WRITE,
  PROBE_RENAME,
  PROBE_VERIFY,
  LOG_DIRECTORY,
  DATA_DIRECTORY,
  ARCHIVE_WRITE,
  ARCHIVE_RENAME,
  DOCUMENT_WRITE,
  DOCUMENT_RENAME,
};
StorageFailureStage storageFailureStage = StorageFailureStage::NONE;
uint32_t storageFailureFreeHeapBytes = 0;
uint32_t storageFailureMinFreeHeapBytes = 0;
uint32_t storageFailureLargestBlockBytes = 0;
uint32_t storageWriteFailures = 0;
uint32_t storageExpectedOffset = 0;
uint32_t storageExpectedSize = 0;
uint32_t storageStoredOffset = 0;
uint32_t storageStoredSize = 0;
uint16_t storageStoredFormatVersion = 0;
bool storageMarkerPresent = false;
volatile bool storageMutationActive = false;
TaskHandle_t storageMutationOwner = nullptr;
uint16_t storageMutationDepth = 0;
volatile bool storageRequestActive = false;
TaskHandle_t storageRequestOwner = nullptr;
// Once an actuation start collides with a read, briefly refuse new library
// transfers so the device-owned retry can acquire storage as soon as the
// already-running transfer finishes. This is scheduling only: it never delays
// Stop and never permits actuation before the mutation guard is held.
// Sized to outlast one library transfer: a 32-recording /api/logs list takes ~2.3 s
// and a manifest ~1.3 s (measured), so a 1.5 s window with 1 s of device-owned retry
// would let every Start lose to back-to-back reconnect hydration.
constexpr uint32_t kActuationStartStoragePriorityMs = 3500;
bool storageMutationPriorityActive = false;
uint32_t storageMutationPriorityUntilMs = 0;
portMUX_TYPE storageMutationMux = portMUX_INITIALIZER_UNLOCKED;

bool otaReservesPort80();

class StorageMutationGuard {
 public:
  explicit StorageMutationGuard(bool required = true, bool prioritize = false)
      : required_(required) {
    if (!required_) {
      acquired_ = true;
      return;
    }
    if (otaReservesPort80()) return;
    const TaskHandle_t current = xTaskGetCurrentTaskHandle();
    const uint32_t nowMs = millis();
    portENTER_CRITICAL(&storageMutationMux);
    // Re-check while owning the storage arbiter. OTA admission takes these
    // locks in the same storage-then-OTA order, closing the preemption gap.
    if (otaReservesPort80()) {
      portEXIT_CRITICAL(&storageMutationMux);
      return;
    }
    const bool priorityActive =
        storageMutationPriorityActive &&
        sr800::runtime::deadlinePending(
            nowMs, storageMutationPriorityUntilMs);
    if (!priorityActive) {
      storageMutationPriorityActive = false;
      storageMutationPriorityUntilMs = 0;
    }
    if (storageMutationActive && storageMutationOwner == current) {
      ++storageMutationDepth;
      if (prioritize) {
        storageMutationPriorityActive = false;
        storageMutationPriorityUntilMs = 0;
      }
      acquired_ = true;
    } else if (!storageMutationActive &&
               (!storageRequestActive || storageRequestOwner == current)) {
      storageMutationActive = true;
      storageMutationOwner = current;
      storageMutationDepth = 1;
      if (prioritize) {
        storageMutationPriorityActive = false;
        storageMutationPriorityUntilMs = 0;
      }
      acquired_ = true;
    } else if (prioritize) {
      storageMutationPriorityActive = true;
      storageMutationPriorityUntilMs =
          nowMs + kActuationStartStoragePriorityMs;
    }
    portEXIT_CRITICAL(&storageMutationMux);
  }
  ~StorageMutationGuard() {
    if (!acquired_ || !required_) return;
    portENTER_CRITICAL(&storageMutationMux);
    if (storageMutationOwner == xTaskGetCurrentTaskHandle() &&
        storageMutationDepth > 0 && --storageMutationDepth == 0) {
      storageMutationOwner = nullptr;
      storageMutationActive = false;
    }
    portEXIT_CRITICAL(&storageMutationMux);
  }
  explicit operator bool() const { return acquired_; }

 private:
  bool required_ = true;
  bool acquired_ = false;
};
uint32_t actuatorIdleSinceMs = 0;
uint32_t thermalLogReservedId = 0;
// True once the accepted-or-pending roast has a valid zero-sample archive on
// LittleFS. The final persist atomically replaces that file rather than
// counting the same occurrence twice.
bool thermalLogProvisionalPersisted = false;

struct ThermalLogStateSnapshot {
  bool active = false;
  bool unsaved = false;
  bool persistenceClaimed = false;
  uint32_t sampleCount = 0;
  // Names the episode the fenced sampleCount belongs to, so a reader can tell
  // when a stop+start recycled the buffer underneath it.
  uint32_t reservedId = 0;
};

ThermalLogStateSnapshot copyThermalLogState() {
  ThermalLogStateSnapshot snapshot;
  portENTER_CRITICAL(&thermalLogMux);
  snapshot.active = thermalLogActive;
  snapshot.unsaved = thermalLogUnsaved;
  snapshot.persistenceClaimed = thermalLogPersistenceClaimed;
  snapshot.sampleCount = thermalLogCount;
  snapshot.reservedId = thermalLogReservedId;
  portEXIT_CRITICAL(&thermalLogMux);
  return snapshot;
}

uint32_t nextLogArchiveId();
void advanceStateRevision();
uint64_t currentStateRevision();
bool persistProvisionalRoastArchive();
void discardProvisionalRoastArchive();

const char* thermalLogSourceName(ThermalLogSource source) {
  switch (source) {
    case ThermalLogSource::PROOF: return "proof";
    case ThermalLogSource::CALIBRATION: return "calibration";
    case ThermalLogSource::MANUAL: return "manual";
    case ThermalLogSource::ROAST: return "roast";
    default: return "none";
  }
}

uint32_t minimumArchivedSamples(ThermalLogSource source) {
  // A roast archive is the durable occurrence record, even when a compact
  // roast is stopped before the general 30-sample evidence floor.
  return source == ThermalLogSource::ROAST ? 1U : kLogArchiveMinSamples;
}

bool terminalRoastArchiveNeedsReplacement() {
  return thermalLogUnsaved &&
      thermalLogSource == ThermalLogSource::ROAST && !roastActive &&
      roastEndReasonCode(roastEndReason) != 0 && thermalLogReservedId != 0 &&
      roastArchivePlanValid;
}

bool meaningfulUnsavedThermalLog() {
  return thermalLogUnsaved &&
      (thermalLogCount >= minimumArchivedSamples(thermalLogSource) ||
       terminalRoastArchiveNeedsReplacement());
}

void startThermalLog(ThermalLogSource source,
                     uint32_t intervalMs = kThermalLogIntervalMs) {
  // Callers must have finalized the preceding episode first. Keep this
  // fail-safe accounting as a last line of defence if a future caller does not.
  if (meaningfulUnsavedThermalLog()) {
    logArchiveLostLogs++;
  }
  const uint32_t reservedId = nextLogArchiveId();
  portENTER_CRITICAL(&thermalLogMux);
  thermalLogCount = 0;
  thermalLogStartMs = millis();
  thermalLogLastSampleMs = 0;
  thermalLogIntervalMs = intervalMs;
  thermalLogThermocoupleOffsetC = thermocoupleOffsetC;
  thermalLogActive = true;
  // Each source marks its capture policy complete at its authoritative boundary.
  // Until then a provisional archive must fail closed across power loss or interruption.
  thermalLogPassiveTailComplete = false;
  thermalLogSource = source;
  thermalLogUnsaved = true;
  thermalLogPersistAttempts = 0;
  thermalLogProvisionalPersisted = false;
  // Reserve the archive identity now. Calibration status and a later .crk
  // therefore name the same recording even across the volatile interval.
  thermalLogReservedId = reservedId;
  portEXIT_CRITICAL(&thermalLogMux);
}

void rollbackThermalLogStart() {
  // A start may reserve an archive id before asking the actuator to change
  // outputs. If that synchronous request is refused, abandon only the new
  // volatile episode; the monotonic NVS id remains consumed deliberately.
  portENTER_CRITICAL(&thermalLogMux);
  thermalLogCount = 0;
  thermalLogStartMs = 0;
  thermalLogLastSampleMs = 0;
  thermalLogIntervalMs = kThermalLogIntervalMs;
  thermalLogActive = false;
  thermalLogPassiveTailComplete = true;
  thermalLogSource = ThermalLogSource::NONE;
  thermalLogUnsaved = false;
  thermalLogPersistAttempts = 0;
  thermalLogProvisionalPersisted = false;
  thermalLogReservedId = 0;
  portEXIT_CRITICAL(&thermalLogMux);
}
// Defined with the archive code below; start paths call it before requesting
// actuation so the flash write lands while outputs are idle.
bool finalizeThermalLogForNewEpisode();
bool takeOverPriorRecordingForNewEpisode(const char*& rejection);
esp_err_t handleNativeStorageRequest(httpd_req_t* request);
esp_err_t handleOtaVersion(httpd_req_t* request);

esp_err_t handleRawOtaUpload(httpd_req_t* request);
bool finishRoast(uint32_t nowUs, const char* endReason);
bool finalizeEndedRoastRecordingForStop();
bool meaningfulUnsavedThermalLog();
void persistUnsavedThermalLog(bool force);
bool nvsMutationAllowed();
DRAM_ATTR volatile uint32_t factoryFanWindowStartUs = 0;
DRAM_ATTR volatile uint32_t factoryFanLastRiseUs = 0;
DRAM_ATTR volatile uint32_t factoryFanPulseCount = 0;
portMUX_TYPE captureMux = portMUX_INITIALIZER_UNLOCKED;
bool sendBoundedResponse(int statusCode, const char* contentType,
                         const String& body,
                         const char* extraHeaderName,
                         const char* extraHeaderValue);


// Request bindings are TASK-LOCAL. The loop task binds a mailbox command here while the
// crackle-store task binds a storage request, concurrently, on the other core; every request helper
// (requestHasArg, requestArg, sendRequestResponse, sendBoundedResponse, HttpResponseWriter) chooses
// between them. As plain globals, a storage handler running while the loop served a command would
// read the COMMAND's query (no `base`, `cursor`, confirm token...) and write its reply into the
// command's mailbox response - a successful Start could reach the browser as a storage error, and
// the storage socket got no reply at all. Thread-local pointers make each task
// see only the binding it set. POD pointers only; ESP-IDF zero-initialises them per task.
static __thread const sr800::network::CommandRequest* nativeCommandRequest = nullptr;
static __thread sr800::network::CommandResponse* nativeCommandResponse = nullptr;
static __thread httpd_req_t* nativeStorageRequest = nullptr;
// Written and read only by the crackle-store task, which is the only task with a storage binding.
String nativeStorageBody;

// Long flash work (directory walks, CSV streams, archive encodes) must let core 0's IDLE task run:
// the task watchdog checks only IDLE0 (CONFIG_ESP_TASK_WDT_CHECK_IDLE_TASK_CPU0) with a 5 s timeout.
// `delay(0)` is `vTaskDelay(0)`, which yields only to tasks of EQUAL OR HIGHER priority - never to
// IDLE, which is below every Crackle worker - so loops that "yielded" with it still starved IDLE0.
// The manifest walk is the typical case (crackle-store inside handleDataManifest ->
// File::openNextFile -> lfs_bd_read): a walk of /data/runs and /logs can take over a second idle,
// grows with every roast and recording, slows under concurrent app traffic, and can cross 5 s
// without IDLE0 ever running.
// pacedYield() sleeps one tick (1 ms at CONFIG_FREERTOS_HZ=1000) after every 20 ms of work on the
// calling task. Never call it inside a portENTER_CRITICAL section.
static __thread uint32_t lastIdleYieldMs = 0;
inline void pacedYield() {
  const uint32_t nowMs = millis();
  if (nowMs - lastIdleYieldMs < 20) return;
  vTaskDelay(1);
  lastIdleYieldMs = millis();
}

const char* nativeHttpStatus(int statusCode) {
  switch (statusCode) {
    case 200: return "200 OK";
    case 202: return "202 Accepted";
    case 307: return "307 Temporary Redirect";
    case 400: return "400 Bad Request";
    case 404: return "404 Not Found";
    case 405: return "405 Method Not Allowed";
    case 408: return "408 Request Timeout";
    case 409: return "409 Conflict";
    case 413: return "413 Content Too Large";
    case 415: return "415 Unsupported Media Type";
    case 423: return "423 Locked";
    case 429: return "429 Too Many Requests";
    case 500: return "500 Internal Server Error";
    case 501: return "501 Not Implemented";
    case 503: return "503 Service Unavailable";
    case 504: return "504 Gateway Timeout";
    case 507: return "507 Insufficient Storage";
    default: return "500 Internal Server Error";
  }
}

bool nativeRequestHasRawContentType(httpd_req_t* request) {
  if (request == nullptr) return false;
  char contentType[64] = {};
  if (httpd_req_get_hdr_value_str(
          request, "Content-Type", contentType, sizeof(contentType)) != ESP_OK) {
    return false;
  }
  static constexpr char expected[] = "application/octet-stream";
  return strncmp(contentType, expected, sizeof(expected) - 1) == 0 &&
      (contentType[sizeof(expected) - 1] == 0 ||
       contentType[sizeof(expected) - 1] == ';');
}

bool nativeStorageQueryArg(const char* name, String& value) {
  if (nativeStorageRequest == nullptr || name == nullptr) return false;
  const size_t queryLength = httpd_req_get_url_query_len(nativeStorageRequest);
  if (queryLength == 0 || queryLength >= sr800::network::kCommandQueryBytes) {
    return false;
  }
  char query[sr800::network::kCommandQueryBytes] = {};
  if (httpd_req_get_url_query_str(nativeStorageRequest, query,
                                  sizeof(query)) != ESP_OK) return false;
  char decoded[sr800::network::kCommandQueryBytes] = {};
  if (!sr800::network::QueryArgs(query).text(name, decoded,
                                             sizeof(decoded))) return false;
  value = decoded;
  return true;
}

String requestPathArg(size_t index) {
  if (nativeStorageRequest == nullptr) return String();
  if (index != 0 || nativeStorageRequest->uri == nullptr) return String();
  const char* uri = nativeStorageRequest->uri;
  const char* segment = nullptr;
  if (strncmp(uri, "/api/data/runs/", 15) == 0) segment = uri + 15;
  else if (strncmp(uri, "/api/data/", 10) == 0) segment = uri + 10;
  else if (strncmp(uri, "/logs/", 6) == 0) segment = uri + 6;
  if (segment == nullptr) return String();
  const char* query = strchr(segment, '?');
  return query == nullptr
      ? String(segment)
      : String(segment).substring(0, static_cast<unsigned>(query - segment));
}

void bindNativeCommandRequest(
    const sr800::network::CommandRequest* request,
    sr800::network::CommandResponse* response) {
  nativeCommandRequest = request;
  nativeCommandResponse = response;
}

void releaseNativeCommandRequest() {
  nativeCommandRequest = nullptr;
  nativeCommandResponse = nullptr;
}

bool requestHasArg(const char* name) {
  if (nativeCommandRequest != nullptr) {
    const char* form = nativeCommandRequest->formUrlEncoded
        ? reinterpret_cast<const char*>(nativeCommandRequest->body) : nullptr;
    // A form field intentionally overrides a duplicate query field. This keeps
    // secrets out of URLs while retaining query compatibility for every route.
    return sr800::network::QueryArgs(
        form == nullptr ? nativeCommandRequest->query : form,
        form == nullptr ? nullptr : nativeCommandRequest->query).has(name);
  }
  if (nativeStorageRequest != nullptr) {
    if (strcmp(name, "plain") == 0) return true;
    String ignored;
    return nativeStorageQueryArg(name, ignored);
  }
  return false;
}

String requestArg(const char* name) {
  if (nativeCommandRequest != nullptr) {
    char value[sr800::network::kCommandQueryBytes] = {};
    const char* form = nativeCommandRequest->formUrlEncoded
        ? reinterpret_cast<const char*>(nativeCommandRequest->body) : nullptr;
    const sr800::network::QueryArgs args(
        form == nullptr ? nativeCommandRequest->query : form,
        form == nullptr ? nullptr : nativeCommandRequest->query);
    if (!args.text(name, value, sizeof(value))) return String();
    return String(value);
  }
  if (nativeStorageRequest != nullptr) {
    if (strcmp(name, "plain") == 0) return nativeStorageBody;
    String value;
    nativeStorageQueryArg(name, value);
    return value;
  }
  return String();
}

void sendRequestResponse(int statusCode, const char* contentType,
                         const String& body) {
  if (nativeCommandResponse == nullptr) {
    if (nativeStorageRequest != nullptr) {
      httpd_resp_set_status(nativeStorageRequest, nativeHttpStatus(statusCode));
      httpd_resp_set_type(nativeStorageRequest,
                          contentType == nullptr ? "application/json" : contentType);
      httpd_resp_set_hdr(nativeStorageRequest, "Cache-Control", "no-store");
      httpd_resp_send(nativeStorageRequest, body.c_str(), body.length());
    }
    return;
  }
  nativeCommandResponse->status = statusCode;
  strlcpy(nativeCommandResponse->contentType,
          contentType == nullptr ? "application/json" : contentType,
          sizeof(nativeCommandResponse->contentType));
  if (body.length() >= sizeof(nativeCommandResponse->body)) {
    static constexpr char overflow[] =
        "{\"ok\":false,\"message\":\"The controller response exceeded its fixed mailbox.\"}";
    nativeCommandResponse->status = 507;
    strlcpy(nativeCommandResponse->contentType, "application/json",
            sizeof(nativeCommandResponse->contentType));
    nativeCommandResponse->bodyLength = sizeof(overflow) - 1;
    memcpy(nativeCommandResponse->body, overflow, sizeof(overflow));
    nativeCommandResponse->stateRevision = currentStateRevision();
    return;
  }
  nativeCommandResponse->bodyLength = body.length();
  memcpy(nativeCommandResponse->body, body.c_str(),
         nativeCommandResponse->bodyLength);
  nativeCommandResponse->body[nativeCommandResponse->bodyLength] = 0;
  nativeCommandResponse->stateRevision = currentStateRevision();
}

enum class LiveCalibrationSettleState : uint8_t {
  CHECKING = 0,
  MINIMUM_DWELL,
  WAITING_FOR_TRANSITION,
  SETTLED,
};

enum class LiveCalibrationOutcome : uint8_t {
  UNKNOWN = 0,
  SETTLED,
  CAPPED,
};

enum class LiveCalibrationEndReason : uint8_t {
  NONE = 0,
  STOPPED,
  FAULT,
  TELEMETRY_STALE,
  QUALIFICATION_STALLED,
  COMPLETED,
  STEP_REJECTED,
  RENEWAL_REJECTED,
  UNKNOWN,
};

struct LiveCalibrationCompletedStep {
  uint8_t index;
  uint8_t fanDeci;
  uint8_t heatDeci;
  uint16_t elapsedSec;
  float temperatureC;
  LiveCalibrationOutcome outcome;
};

const char* liveCalibrationSettleStateName(
    LiveCalibrationSettleState state) {
  switch (state) {
    case LiveCalibrationSettleState::MINIMUM_DWELL:
      return "minimum_dwell";
    case LiveCalibrationSettleState::WAITING_FOR_TRANSITION:
      return "waiting_for_transition";
    case LiveCalibrationSettleState::SETTLED:
      return "settled";
    case LiveCalibrationSettleState::CHECKING:
    default:
      return "checking";
  }
}

const char* liveCalibrationOutcomeName(LiveCalibrationOutcome outcome) {
  switch (outcome) {
    case LiveCalibrationOutcome::SETTLED:
      return "settled";
    case LiveCalibrationOutcome::CAPPED:
      return "capped";
    case LiveCalibrationOutcome::UNKNOWN:
    default:
      return "unknown";
  }
}

const char* liveCalibrationEndReasonName(LiveCalibrationEndReason reason) {
  switch (reason) {
    case LiveCalibrationEndReason::STOPPED: return "stopped";
    case LiveCalibrationEndReason::FAULT: return "fault";
    case LiveCalibrationEndReason::TELEMETRY_STALE: return "telemetry_stale";
    case LiveCalibrationEndReason::QUALIFICATION_STALLED:
      return "qualification_stalled";
    case LiveCalibrationEndReason::COMPLETED: return "completed";
    case LiveCalibrationEndReason::STEP_REJECTED: return "step_rejected";
    case LiveCalibrationEndReason::RENEWAL_REJECTED:
      return "renewal_rejected";
    case LiveCalibrationEndReason::NONE: return "none";
    case LiveCalibrationEndReason::UNKNOWN:
    default:
      return "unknown";
  }
}

LiveCalibrationEndReason liveCalibrationEndReason(const char* reason) {
  if (reason == nullptr || strcmp(reason, "none") == 0) {
    return LiveCalibrationEndReason::NONE;
  }
  if (strcmp(reason, "stopped") == 0) return LiveCalibrationEndReason::STOPPED;
  if (strcmp(reason, "fault") == 0) return LiveCalibrationEndReason::FAULT;
  if (strcmp(reason, "telemetry_stale") == 0) {
    return LiveCalibrationEndReason::TELEMETRY_STALE;
  }
  if (strcmp(reason, "qualification_stalled") == 0) {
    return LiveCalibrationEndReason::QUALIFICATION_STALLED;
  }
  if (strcmp(reason, "completed") == 0) {
    return LiveCalibrationEndReason::COMPLETED;
  }
  if (strcmp(reason, "step_rejected") == 0) {
    return LiveCalibrationEndReason::STEP_REJECTED;
  }
  if (strcmp(reason, "renewal_rejected") == 0) {
    return LiveCalibrationEndReason::RENEWAL_REJECTED;
  }
  return LiveCalibrationEndReason::UNKNOWN;
}

LiveCalibrationSettleState liveCalibrationSettleState(
    uint32_t elapsedSec) {
  if (!calibrationActive) return LiveCalibrationSettleState::CHECKING;
  if (elapsedSec < calibrationMinDwellMs / 1000U) {
    return LiveCalibrationSettleState::MINIMUM_DWELL;
  }
  if (!calibrationSettleDetector.transitionObserved()) {
    return LiveCalibrationSettleState::WAITING_FOR_TRANSITION;
  }
  return calibrationStepSettled()
      ? LiveCalibrationSettleState::SETTLED
      : LiveCalibrationSettleState::CHECKING;
}
// Reset reasons of the most recent boots, newest first, persisted in the diagnostics
// namespace at boot (an idle-time NVS write). The current boot's reason only says how
// the previous run ended; the ring makes a session of repeated resets visible after the
// next power cycle, where a single-boot reset_reason cannot attribute repeated reboots.
constexpr size_t kBootHistoryCapacity = 8;
// The last crash recorded in the core-dump flash partition (CONFIG_ESP_COREDUMP_ENABLE_TO_FLASH),
// summarised once in setup() before networking or actuation start and never written again, so
// status readers on any task see an immutable value. It makes the backtrace of a watchdog reset or
// panic visible over HTTP without serial access.
struct StoredCrashSummary {
  bool present;
  bool corrupted;
  char task[17];
  uint32_t pc;
  uint8_t depth;
  uint32_t backtrace[16];
  char elfSha256[17];
  // True when the dump's ELF hash is the running image's; false for a crash of an earlier build.
  bool currentBuild;
};
StoredCrashSummary storedCrash = {};
// ESP-IDF's PSRAM minimum has been observed reading 0 a minute after boot with 1.9 MB free, so
// the firmware keeps its own sampled low-water and counts failed allocations to say what happened.
portMUX_TYPE heapDiagnosticsMux = portMUX_INITIALIZER_UNLOCKED;
uint32_t psramLowWaterBytes = UINT32_MAX;
uint32_t psramLowWaterAtMs = 0;
uint32_t failedAllocationCount = 0;
uint32_t lastFailedAllocationBytes = 0;
uint32_t lastFailedAllocationCaps = 0;
uint32_t lastFailedAllocationAtMs = 0;
// Runs inside the allocator's failure path, possibly on any task: no allocation, no logging.
void recordFailedAllocation(size_t size, uint32_t caps, const char*) {
  const uint32_t nowMs = static_cast<uint32_t>(esp_timer_get_time() / 1000);
  portENTER_CRITICAL_SAFE(&heapDiagnosticsMux);
  failedAllocationCount++;
  lastFailedAllocationBytes = static_cast<uint32_t>(size);
  lastFailedAllocationCaps = caps;
  lastFailedAllocationAtMs = nowMs;
  portEXIT_CRITICAL_SAFE(&heapDiagnosticsMux);
}
void samplePsramLowWater(uint32_t nowMs) {
  const uint32_t freeBytes = static_cast<uint32_t>(heap_caps_get_free_size(MALLOC_CAP_SPIRAM));
  portENTER_CRITICAL(&heapDiagnosticsMux);
  if (freeBytes < psramLowWaterBytes) {
    psramLowWaterBytes = freeBytes;
    psramLowWaterAtMs = nowMs;
  }
  portEXIT_CRITICAL(&heapDiagnosticsMux);
}
struct BootHistoryEntry {
  uint32_t bootId;
  uint8_t resetReason;
};
// The asynchronous WebSocket server runs in an ESP-IDF HTTP task. The Arduino loop publishes this
// compact DTO so that task never reaches into actuator locks or loop-owned program state.
struct LiveStatusSnapshot {
  sr800::ActuatorSnapshot actuator;
  float thermocoupleC;
  float coldJunctionC;
  uint32_t calibrationStepIndex;
  uint32_t calibrationStepCount;
  uint32_t calibrationLogId;
  uint32_t calibrationStepElapsedSec;
  uint32_t manualSinceMs;
  uint32_t thermalLogCount;
  uint32_t thermalLogId;
  ThermalLogSource thermalLogSource;
  bool thermalLogActive;
  bool manualConflictLatched;
  uint8_t calibrationCurrentFanDeci;
  uint8_t calibrationCurrentHeatDeci;
  uint8_t calibrationCompletedStepCount;
  LiveCalibrationSettleState calibrationSettleState;
  LiveCalibrationEndReason calibrationEndReason;
  LiveCalibrationCompletedStep
      calibrationCompletedSteps[kCalibrationCompletedEventCount];
  bool calibrationActive;
  bool manualActive;
  // The roast essentials, so a live client can render the run without polling
  // the full status document. Everything here is a plain scalar copied under
  // the same mux; the WebSocket task never reaches into program state.
  uint32_t roastElapsedSec;
  uint32_t bootId;
  uint32_t streamSeq;
  uint32_t roastSessionId;
  uint32_t roastPlanRevision;
  uint32_t roastStartedEpoch;
  char roastName[kRoastNameBytes + 1];
  uint64_t stateRevision;
  uint32_t lastCommandId;
  uint16_t lastCommandStatus;
  uint32_t roastZoneIndex;
  uint32_t roastZoneCount;
  float roastTargetC;
  float roastAmbientC;
  float roastBatchMassG;
  bool roastActive;
  bool roastJourney;
  bool roastSaturated;
  bool roastHoldover;
  RoastMode roastMode;
  // Per-tick Journey executor progress. Browsers defer the full status
  // document for as long as anything actuates, so this compact snapshot is the
  // ONLY status transport during a roast: everything the cockpit renders per
  // tick - the zone tuple (entry, nominal duration, endpoint), the live
  // correction, the solver's own levels, the holdover clock, per-zone
  // attainment offsets, and how the roast ended - must ride here, published
  // atomically with the zone index so the tuple can never mix two zones.
  uint32_t roastZoneEntrySec;
  uint32_t roastZoneNominalSec;
  float roastZoneEndC;
  float roastCorrectionTotal;
  float roastIntegral;
  float roastSolvedFan;
  float roastSolvedHeat;
  uint32_t roastHoldoverMs;
  uint16_t roastZoneAttainedSec[sr800::kMaxJourneyZones];
  char roastEndReason[24];

  // Full-status fields are copied into the same immutable publication. Native
  // network tasks never read controller globals or LittleFS directly.
  bool sensorConfigured;
  bool temperatureValid;
  float thermocoupleOffsetC;
  uint8_t sensorFaultStatus;
  uint32_t sensorSampleAgeMs;
  bool calibrationReady;
  uint32_t calibrationStableForMs;
  char calibrationReadiness[24];
  uint32_t calibrationMaxStepSeconds;
  uint32_t calibrationMinStepSeconds;
  uint32_t calibrationSettleSeconds;
  float calibrationSettleBandC;
  uint32_t calibrationStartedEpoch;
  uint32_t calibrationCompletedEpoch;
  bool thermalLogUnsaved;
  bool recordingAvailable;
  uint32_t thermalLogIntervalMs;
  uint32_t manualFanMilli;
  uint32_t manualHeatMilli;
  uint32_t manualInstructionAgeMs;
  char manualEndReason[24];
  bool logArchiveMounted;
  bool logArchiveNeedsFormat;
  uint32_t logArchiveCount;
  uint32_t logArchiveLostLogs;
  bool dataStoreMounted;
  uint32_t dataStoreUsedBytes;
  uint32_t dataStoreRunCount;
  uint32_t dataStoreRunBytes;
  uint32_t storageTotalBytes;
  bool appliedCalibrationPresent;
  float heaterGain;
  float fanCooling;
  float coolingFan;
  float lossPerMin;
  char calibrationFitId[48];
  uint32_t calibrationAppliedEpoch;
  bool restoreActive;
  bool restoreIncomplete;
  uint32_t restoreExpiresInMs;
  bool clockSynced;
  bool stationConnected;
  int32_t stationRssiDbm;
  uint32_t wifiDisconnectCount;
  uint32_t wifiPollReconnectAttemptCount;
  uint32_t wifiGotIpCount;
  uint32_t wifiLastDisconnectMs;
  uint32_t wifiLastGotIpMs;
  uint8_t wifiLastDisconnectReason;
  bool actuationWifiAwake;
  bool wifiSleepEnabled;
  uint32_t appUsedBytes;
  uint32_t appSlotBytes;
  esp_reset_reason_t resetReason;
  uint8_t bootHistoryCount;
  BootHistoryEntry bootHistory[kBootHistoryCapacity];
  uint32_t uptimeMs;
  uint32_t freeHeapBytes;
  uint32_t minimumFreeHeapBytes;
  uint32_t largestFreeHeapBlockBytes;
  uint32_t freePsramBytes;
  uint32_t minimumFreePsramBytes;
  uint32_t largestFreePsramBlockBytes;
  uint32_t lastLoopGapMs;
  uint32_t maximumLoopGapMs;
  uint32_t lastArchivePersistMs;
  uint32_t maximumArchivePersistMs;
  uint32_t archivePersistCount;
};
portMUX_TYPE liveStatusMux = portMUX_INITIALIZER_UNLOCKED;
LiveStatusSnapshot liveStatusSnapshot = {};
uint32_t liveStatusLastPublishMs = 0;
uint32_t cachedAppUsedBytes = 0;
uint32_t lastNetworkCommandId = 0;
uint32_t cachedAppSlotBytes = 0;
uint16_t lastNetworkCommandStatus = 0;

temperature_sensor_handle_t chipTemperatureSensor = nullptr;
bool signalInterruptsAttached = false;
bool stationConfigured = false;
bool mdnsStarted = false;
bool apActive = false;
bool actuationWifiAwake = false;
String stationSsid;
uint32_t lastReconnectAttemptMs = 0;
uint32_t lastApStartAttemptMs = 0;
uint32_t stationConnectedSinceMs = 0;
uint32_t stationDisconnectedSinceMs = 0;
portMUX_TYPE wifiEventMux = portMUX_INITIALIZER_UNLOCKED;
uint32_t wifiDisconnectCount = 0;
uint32_t wifiPollReconnectAttemptCount = 0;
uint32_t wifiGotIpCount = 0;
uint32_t wifiLastDisconnectMs = 0;
uint32_t wifiLastGotIpMs = 0;
uint8_t wifiLastDisconnectReason = 0;
uint32_t bootCount = 0;
BootHistoryEntry bootHistory[kBootHistoryCapacity] = {};
uint8_t bootHistoryCount = 0;
esp_reset_reason_t bootResetReason = ESP_RST_UNKNOWN;

volatile bool updateStarted = false;
volatile bool updateFinished = false;
volatile bool otaHandleActive = false;
esp_ota_handle_t otaHandle = 0;
const esp_partition_t* otaTargetPartition = nullptr;
esp_err_t otaError = ESP_OK;
size_t otaBytesWritten = 0;
// Written by the OTA handler task only while admission is GRANTED and read by loopTask only
// while admission is IDLE — temporally exclusive, but volatile keeps the cross-task intent
// explicit and the worst stale read is one redundant idempotent revalidation call.
volatile bool otaImageValidated = false;
volatile bool otaBootPartitionSelected = false;
volatile bool otaRestartPending = false;
uint32_t otaRestartRequestedMs = 0;
portMUX_TYPE otaStateMux = portMUX_INITIALIZER_UNLOCKED;
enum class OtaAdmissionState : uint8_t {
  IDLE = 0, REQUESTED, GRANTING, GRANTED, DENIED, RELEASE_REQUESTED, COMMITTED,
};
volatile OtaAdmissionState otaAdmissionState = OtaAdmissionState::IDLE;
bool otaHealthResponseServed = false;

struct OtaAttemptDiagnostics {
  bool attempted = false;
  uint32_t declaredBytes = 0;
  uint32_t receivedBytes = 0;
  uint32_t targetOffset = 0;
  esp_err_t error = ESP_OK;
  bool readbackComplete = false;
  bool readbackMatched = false;
  char receivedSha256[65] = {};
  char flashSha256[65] = {};
};

OtaAttemptDiagnostics otaLastAttempt;

OtaAttemptDiagnostics copyOtaAttemptDiagnostics() {
  portENTER_CRITICAL(&otaStateMux);
  const OtaAttemptDiagnostics snapshot = otaLastAttempt;
  portEXIT_CRITICAL(&otaStateMux);
  return snapshot;
}

void publishOtaAttemptDiagnostics(const OtaAttemptDiagnostics& diagnostics) {
  portENTER_CRITICAL(&otaStateMux);
  otaLastAttempt = diagnostics;
  portEXIT_CRITICAL(&otaStateMux);
}

void markOtaHealthResponseServed() {
  portENTER_CRITICAL(&otaStateMux);
  otaHealthResponseServed = true;
  portEXIT_CRITICAL(&otaStateMux);
}

bool copyOtaHealthResponseServed() {
  portENTER_CRITICAL(&otaStateMux);
  const bool served = otaHealthResponseServed;
  portEXIT_CRITICAL(&otaStateMux);
  return served;
}

bool max31856Configured = false;
float maxThermocoupleRawC = NAN;
float maxThermocoupleC = NAN;
float maxColdJunctionC = NAN;
uint8_t maxFaultStatus = 0xFF;
uint32_t maxLastSampleMs = 0;

bool thermocoupleFreshValid(uint32_t nowMs, uint32_t maximumAgeMs) {
  return max31856Configured && maxFaultStatus == 0 &&
      !isnan(maxThermocoupleC) && maxLastSampleMs != 0 &&
      nowMs - maxLastSampleMs < maximumAgeMs;
}

bool heatStartTemperatureHealthy(uint32_t nowMs,
                                 uint32_t maximumAgeMs = 1000U) {
  return thermocoupleFreshValid(nowMs, maximumAgeMs) &&
      maxThermocoupleC < kOvertempDisableC;
}

struct Max31856FaultReason {
  uint8_t mask;
  const char* name;
};

constexpr Max31856FaultReason kMax31856FaultReasons[] = {
    {0x80U, "cold_junction_range"},
    {0x40U, "thermocouple_range"},
    {0x20U, "cold_junction_high"},
    {0x10U, "cold_junction_low"},
    {0x08U, "thermocouple_high"},
    {0x04U, "thermocouple_low"},
    {0x02U, "over_under_voltage"},
    {0x01U, "open_circuit"},
};

void formatMax31856FaultReasonsJson(uint8_t status, bool configured,
                                    char* buffer, size_t capacity) {
  if (buffer == nullptr || capacity < 3) return;
  size_t used = 0;
  buffer[used++] = '[';
  if (!configured) {
    const int length = snprintf(buffer + used, capacity - used, "\"not_configured\"");
    if (length > 0 && static_cast<size_t>(length) < capacity - used) used += static_cast<size_t>(length);
  } else {
    bool first = true;
    for (const Max31856FaultReason& reason : kMax31856FaultReasons) {
      if ((status & reason.mask) == 0) continue;
      const int length = snprintf(buffer + used, capacity - used,
                                  "%s\"%s\"", first ? "" : ",", reason.name);
      if (length <= 0 || static_cast<size_t>(length) >= capacity - used) break;
      used += static_cast<size_t>(length);
      first = false;
    }
  }
  if (used + 2 > capacity) used = 0;
  buffer[used++] = ']';
  buffer[used] = 0;
}
uint32_t maxLastConfigureAttemptMs = 0;
sr800::runtime::SustainedCondition overtemperatureCondition;
sr800::SensorFaultQualifier maxSensorFaultQualifier;
sr800::CalibrationReadiness calibrationReadiness;

void recordCalibrationCompletedStep(uint32_t nowUs, const char* outcome) {
  if (calibrationCompletedEventUsed >= kCalibrationCompletedEventCount) {
    memmove(calibrationCompletedEvents, calibrationCompletedEvents + 1,
            (kCalibrationCompletedEventCount - 1) *
                sizeof(CalibrationCompletedEvent));
    calibrationCompletedEventUsed = kCalibrationCompletedEventCount - 1;
  }
  CalibrationCompletedEvent& event =
      calibrationCompletedEvents[calibrationCompletedEventUsed++];
  event.index = static_cast<uint8_t>(calibrationStepIndex);
  const uint32_t elapsed = (nowUs - calibrationStepStartedUs) / 1000000U;
  event.elapsedSec = static_cast<uint16_t>(elapsed > UINT16_MAX ? UINT16_MAX : elapsed);
  const uint32_t fanDeci =
      (calibrationStepFanMilli[calibrationStepIndex] + 50U) / 100U;
  const uint32_t heatDeci =
      (calibrationHeatMilli[calibrationStepIndex] + 50U) / 100U;
  event.fanDeci = static_cast<uint8_t>(fanDeci > 100U ? 100U : fanDeci);
  event.heatDeci = static_cast<uint8_t>(heatDeci > 100U ? 100U : heatDeci);
  const uint32_t nowMs = millis();
  const bool temperatureValid = thermocoupleFreshValid(nowMs, 1000U);
  event.temperatureC = temperatureValid ? maxThermocoupleC : NAN;
  event.outcome = outcome;
}


uint8_t IRAM_ATTR readAllLevels() {
  uint8_t levels = 0;
  for (size_t index = 0; index < kChannelCount; ++index) {
    levels |= static_cast<uint8_t>(gpio_get_level(kPins[index]) << index);
  }
  return levels;
}

void ARDUINO_ISR_ATTR onAnyEdge() {
  const uint32_t nowUs = micros();
  const uint8_t levels = readAllLevels();

  portENTER_CRITICAL_ISR(&captureMux);
  const uint8_t changed = static_cast<uint8_t>((levels ^ lastLevels) & 0x0F);
  if (changed == 0) {
    portEXIT_CRITICAL_ISR(&captureMux);
    return;
  }

  seenHighMask |= levels;
  seenLowMask |= static_cast<uint8_t>((~levels) & 0x0F);

  for (size_t index = 0; index < kChannelCount; ++index) {
    const uint8_t mask = static_cast<uint8_t>(1U << index);
    if ((changed & mask) == 0) continue;

    const uint32_t durationUs = nowUs - lastEdgeUs[index];
    const bool wasHigh = (lastLevels & mask) != 0;
    if (wasHigh) {
      fallCount[index] = fallCount[index] + 1;
      lastHighUs[index] = durationUs;
      if (durationUs < minHighUs[index]) minHighUs[index] = durationUs;
      if (durationUs > maxHighUs[index]) maxHighUs[index] = durationUs;
    } else {
      riseCount[index] = riseCount[index] + 1;
      lastLowUs[index] = durationUs;
      if (durationUs < minLowUs[index]) minLowUs[index] = durationUs;
      if (durationUs > maxLowUs[index]) maxLowUs[index] = durationUs;
    }
    lastEdgeUs[index] = nowUs;
  }

  if (captureEnabled) {
    const uint32_t sequence = eventCount + 1;
    const size_t bufferIndex = sequence - 1;
    eventBuffer[bufferIndex].atUs = nowUs;
    eventBuffer[bufferIndex].precedingGapUs = nowUs - lastEventUs;
    eventBuffer[bufferIndex].changedMask = changed;
    eventBuffer[bufferIndex].levels = levels;
    eventBuffer[bufferIndex].sequence = sequence;
    lastEventUs = nowUs;
    eventCount = sequence;

    if (sequence >= kEventCapacity) {
      captureEnabled = false;
      captureComplete = true;
      captureStopReason = kStopEventLimit;
    }
  }

  lastLevels = levels;
  portEXIT_CRITICAL_ISR(&captureMux);
}

void ARDUINO_ISR_ATTR onChannel2Edge() {
  onAnyEdge();

  const uint32_t nowUs = micros();
  bool shouldLatchConflict = false;
  portENTER_CRITICAL_ISR(&captureMux);
  if (factoryFanLastRiseUs == 0 ||
      nowUs - factoryFanLastRiseUs > kFactoryFanMaximumGapUs) {
    factoryFanWindowStartUs = nowUs;
    factoryFanPulseCount = 1;
  } else {
    factoryFanPulseCount = factoryFanPulseCount + 1;
  }
  factoryFanLastRiseUs = nowUs;

  if (!manualConflictLatched &&
      factoryFanPulseCount >= 2 &&
      nowUs - factoryFanWindowStartUs >= kFactoryFanDetectionSpanUs) {
    manualConflictLatched = true;
    fanTestActive = false;
    shouldLatchConflict = true;
  }
  portEXIT_CRITICAL_ISR(&captureMux);

  if (shouldLatchConflict) {
    heaterProofPhase = HeaterProofPhase::IDLE;
    actuator.latchManualConflict();
  }
}

void ARDUINO_ISR_ATTR onMcpwmZeroCross(void*, uint32_t nowUs) {
  actuator.onZeroCross(nowUs);
  onAnyEdge();
}

void ARDUINO_ISR_ATTR onMcpwmZeroCrossDiscontinuity(
    void*, uint32_t nowUs) {
  actuator.onZeroCrossDiscontinuity(nowUs);
}

const char* zeroCrossRejectReasonName(uint8_t reason) {
  switch (static_cast<sr800::ZeroCrossRejectReason>(reason)) {
    case sr800::ZeroCrossRejectReason::NONE: return "none";
    case sr800::ZeroCrossRejectReason::TOO_LONG: return "too_long";
    default: return "unknown";
  }
}

bool enterActuationWifiAwakeMode() {
  if (actuationWifiAwake) return true;
  if (WiFi.getSleep() != WIFI_PS_NONE) {
    if (!WiFi.setSleep(false)) return false;
    // Outputs are still off. Let the radio complete the power-state change
    // before the first zero-cross-synchronized pulse is requested.
    delay(50);
  }
  actuationWifiAwake = true;
  return true;
}

bool waitForActuationStartTiming(const char*& rejection) {
  const uint32_t startedMs = millis();
  do {
    const sr800::PhaseSchedulerSnapshot schedulerState =
        phaseScheduler.snapshot();
    if (!schedulerState.initialized || schedulerState.faulted) {
      rejection = "The zero-cross timing scheduler is unavailable.";
      return false;
    }
    const sr800::ActuatorSnapshot actuatorState =
        actuator.snapshot(micros());
    if (schedulerState.zeroCrossQualified &&
        actuatorState.zeroCrossAvailable &&
        actuatorState.lastZeroCrossAgeUs <= kZeroCrossTimeoutUs) {
      return true;
    }
    // Outputs are still low. Yield to the runtime while the ISR observes the
    // required consecutive mains edges; this is normally about 50 ms.
    delay(1);
  } while (millis() - startedMs < kActuationStartTimingWaitMs);

  rejection =
      "Stable zero-cross timing did not return after storage preparation.";
  return false;
}

void exitActuationWifiAwakeMode() {
  // This mains-powered controller keeps the station radio awake even while
  // outputs are idle. Idle power-save has caused an otherwise healthy
  // association to become unreachable until a power cycle.
  actuationWifiAwake = false;
}

/*
 * The post-stop cooling tail. Requirement: a roast-ending Stop runs Fan 10 /
 * Heat 0 for 10 seconds, and that tail never blocks manual controls.
 *
 * A Stop that interrupts an ACTIVE ROAST leaves a stationary bean mass against
 * a still-hot element and plate; an instantly-dead fan lets residual heat
 * scorch the beans. So the roast EXECUTOR follows such a Stop with Fan 10 /
 * Heat 0 for ten seconds, then turns both outputs off. This is an executor-authored instruction like any other: the
 * actuator core's audited "Heat-off creates no cooling debt, timer, or forced
 * fan" contract is untouched. The tail never blocks anything — any newly
 * accepted instruction (a manual set, a new start, a second Stop) preempts it
 * immediately, and the roast's recording closure and end_reason are unaffected
 * by it: the tail is post-record, like the machine's own cooling.
 */
constexpr uint32_t kPostStopCoolingTailMs = 10000;
constexpr uint32_t kPostStopCoolingFanMilli = 10000;
bool postStopCoolingActive = false;
uint32_t postStopCoolingEndMs = 0;

// A newly accepted instruction owns the actuator from here on; the tail only
// stands down its deadline and never touches the successor's outputs.
void releasePostStopCoolingTail() {
  postStopCoolingActive = false;
  postStopCoolingEndMs = 0;
}

// A new program start must find idle outputs, so the tail is ended — not
// waited out — before the start's own gates run.
void preemptPostStopCoolingTail(uint32_t nowUs) {
  if (!postStopCoolingActive) return;
  releasePostStopCoolingTail();
  actuator.stop(nowUs);
}

// Fan-only, so no thermal gate and no lease is involved; a rejection simply
// leaves the outputs off exactly as every stop did before the tail existed.
void beginPostStopCoolingTail(uint32_t nowUs) {
  (void)nowUs;  // the actuator gets a fresh micros(), see serviceDiagnosticTests
  const char* rejection = nullptr;
  if (actuator.request(kPostStopCoolingFanMilli, 0, micros(), rejection)) {
    postStopCoolingActive = true;
    postStopCoolingEndMs = millis() + kPostStopCoolingTailMs;
  }
}

bool stopDiagnosticTest() {
  portENTER_CRITICAL(&captureMux);
  fanTestActive = false;
  portEXIT_CRITICAL(&captureMux);
  if (calibrationActive) {
    calibrationActive = false;
    calibrationEndReason = "stopped";
  }
  if (manualActive) {
    manualActive = false;
    manualEndReason = "stopped";
  }
  heaterProofPhase = HeaterProofPhase::IDLE;
  const bool roastWasActive = roastActive;
  if (roastActive) finishRoast(micros(), "stopped");
  actuator.stop(micros());
  // Stop means all outputs off, including an overtemperature cooldown.
  actuator.cancelOvertempCooldown(micros());
  // A repeated Stop during a cooling tail means genuinely off, now.
  releasePostStopCoolingTail();
  // Only a Stop that interrupted an active roast earns the cooling tail;
  // stopping a test, a calibration, or an idle machine turns outputs off as
  // it always has.
  if (roastWasActive) beginPostStopCoolingTail(micros());
  return finalizeEndedRoastRecordingForStop();
}

constexpr char kStorageBusyStartRejection[] =
    "Controller storage is busy; retry the start when the current transfer finishes.";

bool isStorageBusyStartRejection(const char* rejection) {
  return rejection != nullptr &&
         strcmp(rejection, kStorageBusyStartRejection) == 0;
}

void sendActuationStartRejection(const char* rejection,
                                 const char* fallback) {
  const bool storageBusy = isStorageBusyStartRejection(rejection);
  if (nativeCommandResponse != nullptr) {
    nativeCommandResponse->retryStorageBusy = storageBusy;
  }
  String response = F("{\"ok\":false");
  if (storageBusy) response += F(",\"code\":\"storage_busy\"");
  response += F(",\"message\":\"");
  response += rejection == nullptr ? fallback : rejection;
  response += F("\"}");
  sendRequestResponse(storageBusy ? 503 : 409, "application/json", response);
}

bool startFanTest(uint32_t durationMs, uint32_t levelMilli,
                  const char*& rejection) {
  // A newly accepted start preempts the post-stop cooling tail immediately.
  preemptPostStopCoolingTail(micros());
  if (heaterProofPhase != HeaterProofPhase::IDLE || roastActive ||
      actuator.outputsActive()) {
    rejection = "Another actuator operation is active.";
    return false;
  }
  StorageMutationGuard storage(true, true);
  if (!storage) {
    rejection = kStorageBusyStartRejection;
    return false;
  }
  // A fan test mid-decay would destroy the passive tail the loss fit needs

  // while recording into a log labeled with the PREVIOUS run's source. Close
  // and persist that log first, exactly as the proof and calibration paths do.

  if (!takeOverPriorRecordingForNewEpisode(rejection)) {
    return false;
  }
  if (!enterActuationWifiAwakeMode()) {
    rejection = "Wi-Fi awake mode could not be enabled.";
    return false;
  }
  if (!waitForActuationStartTiming(rejection)) {
    exitActuationWifiAwakeMode();
    return false;
  }
  const uint32_t nowUs = micros();
  phaseScheduler.beginTimingLog();
  if (!actuator.request(levelMilli, 0, micros(), rejection)) {
    phaseScheduler.endTimingLog();
    exitActuationWifiAwakeMode();
    return false;
  }

  const sr800::PhaseSchedulerSnapshot schedulerState =
      phaseScheduler.snapshot();
  portENTER_CRITICAL(&captureMux);
  fanTestEndUs = nowUs + durationMs * 1000U;
  fanTestLevelMilli = levelMilli;
  fanTestStartPulseCount = schedulerState.fanPulsesEmitted;
  fanTestActive = true;
  portEXIT_CRITICAL(&captureMux);
  return true;
}

bool startHeaterProof(uint32_t durationMs, uint32_t fanLevelMilli,
                       uint32_t heatLevelMilli, const char*& rejection) {
  if (thermalLog == nullptr) {
    rejection = "External recording memory is unavailable.";
    return false;
  }
  // A newly accepted start preempts the post-stop cooling tail immediately.
  preemptPostStopCoolingTail(micros());
  if (fanTestActive || heaterProofPhase != HeaterProofPhase::IDLE ||
      roastActive || actuator.outputsActive()) {
    rejection = "Another actuator operation is active.";
    return false;
  }

  StorageMutationGuard storage(true, true);
  if (!storage) {
    rejection = kStorageBusyStartRejection;
    return false;
  }
  if (!takeOverPriorRecordingForNewEpisode(rejection)) {
    return false;
  }
  startThermalLog(ThermalLogSource::PROOF);
  if (!enterActuationWifiAwakeMode()) {
    rejection = "Wi-Fi awake mode could not be enabled.";
    rollbackThermalLogStart();
    return false;
  }
  if (!waitForActuationStartTiming(rejection)) {
    rollbackThermalLogStart();
    exitActuationWifiAwakeMode();
    return false;
  }
  const uint32_t nowUs = micros();
  phaseScheduler.beginTimingLog();
  if (!actuator.request(fanLevelMilli, heatLevelMilli, micros(), rejection,
                        durationMs * 1000U)) {
    phaseScheduler.endTimingLog();
    rollbackThermalLogStart();
    exitActuationWifiAwakeMode();
    return false;
  }
  const sr800::PhaseSchedulerSnapshot schedulerState = phaseScheduler.snapshot();
  heaterProofDurationMs = durationMs;
  heaterProofFanLevelMilli = fanLevelMilli;
  heaterProofHeatLevelMilli = heatLevelMilli;
  heaterProofDeadlineUs = 0;
  heaterProofStartPulseCount = schedulerState.heaterPulsesEmitted;
  heaterProofQualificationStartedUs = nowUs;
  heaterProofPhase = HeaterProofPhase::FAN_QUALIFICATION;
  return true;
}

bool startCalibration(const uint32_t* fanMilli, const uint32_t* heatMilli,
                      size_t stepCount, uint32_t maximumStepSeconds,
                      uint32_t minDwellSeconds, uint8_t settleSeconds,
                      float settleBandC, const char*& rejection) {
  if (thermalLog == nullptr) {
    rejection = "External recording memory is unavailable.";
    return false;
  }
  // A newly accepted start preempts the post-stop cooling tail immediately.
  preemptPostStopCoolingTail(micros());
  if (fanTestActive || heaterProofPhase != HeaterProofPhase::IDLE ||
      calibrationActive || roastActive ||
      actuator.outputsActive()) {
    rejection = "Another actuator operation is active.";
    return false;
  }

  StorageMutationGuard storage(true, true);
  if (!storage) {
    rejection = kStorageBusyStartRejection;
    return false;
  }
  // Persist the PREVIOUS episode while its own captured plan is still intact.

  // Replacing calibrationArchivePlan before this point would relabel an unsaved
  // prior calibration with the program about to start.
  if (!takeOverPriorRecordingForNewEpisode(rejection)) {
    return false;
  }
  if (!captureCalibrationArchivePlan(
          fanMilli, heatMilli, stepCount, maximumStepSeconds,
          minDwellSeconds, settleSeconds, settleBandC)) {
    rejection = "The calibration program could not be encoded into recording provenance.";
    return false;
  }
  startThermalLog(ThermalLogSource::CALIBRATION);
  calibrationStableLogId = thermalLogReservedId;
  if (!enterActuationWifiAwakeMode()) {
    rejection = "Wi-Fi awake mode could not be enabled.";
    rollbackThermalLogStart();
    calibrationStableLogId = 0;
    return false;
  }
  if (!waitForActuationStartTiming(rejection)) {
    rollbackThermalLogStart();
    calibrationStableLogId = 0;
    exitActuationWifiAwakeMode();
    return false;
  }
  const uint32_t nowUs = micros();
  if (!actuator.request(fanMilli[0], heatMilli[0], micros(), rejection,
                        heatMilli[0] > 0 ? kHeaterProofMaximumMs * 1000U
                                         : 0)) {
    rollbackThermalLogStart();
    calibrationStableLogId = 0;
    exitActuationWifiAwakeMode();
    return false;
  }
  for (size_t index = 0; index < kCalibrationMaxSteps; ++index) {
    calibrationStepFanMilli[index] = index < stepCount ? fanMilli[index] : 0;
    calibrationHeatMilli[index] = index < stepCount ? heatMilli[index] : 0;
  }
  calibrationStepCount = stepCount;
  calibrationStepIndex = 0;
  calibrationStepRequestPending = false;
  calibrationStepMs = maximumStepSeconds * 1000U;
  calibrationMinDwellMs =
      (minDwellSeconds > maximumStepSeconds ? maximumStepSeconds
                                            : minDwellSeconds) * 1000U;
  calibrationSettleSeconds = settleSeconds;
  calibrationSettleBandC = settleBandC;
  calibrationHeatObserved = false;
  calibrationStepStartedUs = nowUs;
  calibrationStepDeadlineArmed = heatMilli[0] == 0;
  calibrationStepEndUs = calibrationStepDeadlineArmed
      ? nowUs + calibrationStepMs * 1000U : 0;
  calibrationLastRenewUs = nowUs;
  calibrationRenewals = 0;
  calibrationEndReason = "none";
  calibrationLastAdvance = "none";
  calibrationCompletedEventUsed = 0;
  calibrationStartedEpoch = 0;
  calibrationCompletedEpoch = 0;
  resetCalibrationSettle();
  calibrationActive = true;
  const time_t calibrationNow = time(nullptr);
  calibrationStartedEpoch = calibrationNow > 1600000000
      ? static_cast<uint32_t>(calibrationNow) : 0;
  return true;
}

// Transient actuator refusals. The audited actuator core refuses a request while
// the last zero-cross is more than 100 ms old, even though it deliberately rides
// a 250 ms recovery grace before latching ZERO_CROSS_LOST; and it refuses Heat
// while thermal status is UNKNOWN, which one invalid MAX31856 sample sets for
// 250 ms, well before the 3-sample/750 ms sensor-fault qualifier. Neither is a
// fault. A renewal or step boundary that lands on one keeps the previous
// command and retries on a later loop pass instead of ending the program. The
// retry window is bounded, so a persisting problem still ends it; any latched
// actuator fault is never treated as transient; and the 30 s ISR heat lease and
// the 1 s thermal-stale trip remain the independent backstops.
// Both strings are the core's own rejection texts (sr800_actuator.cpp).
constexpr char kZeroCrossWaitRejection[] = "Zero-cross timing is unavailable.";
constexpr char kThermalTelemetryRejection[] =
    "Fresh fault-free thermocouple telemetry is required.";
constexpr uint32_t kTransientRejectionRetryMs = 2000;

struct TransientRejectionRetry {
  bool pending = false;
  uint32_t sinceMs = 0;
  uint32_t lastMs = 0;
};
TransientRejectionRetry roastRejectionRetry;
TransientRejectionRetry calibrationRejectionRetry;
TransientRejectionRetry manualRejectionRetry;

bool transientActuatorRejection(const char* rejection) {
  if (rejection == nullptr) return false;
  const sr800::ActuatorSnapshot current = actuator.snapshot(micros());
  if (current.fault != sr800::ActuatorFault::NONE) return false;
  if (strcmp(rejection, kZeroCrossWaitRejection) == 0) return true;
  return strcmp(rejection, kThermalTelemetryRejection) == 0 &&
      current.thermalSafetyStatus == sr800::ThermalSafetyStatus::UNKNOWN;
}

// True: skip this pass, keep the previous command, and retry. False: the
// refusal is real (or has persisted past the window) and the program ends.
bool retryTransientRejection(TransientRejectionRetry& retry,
                             const char* rejection) {
  const uint32_t nowMs = millis();
  if (!transientActuatorRejection(rejection)) {
    retry.pending = false;
    return false;
  }
  // A window left over from an unrelated earlier episode never carries over.
  if (!retry.pending || nowMs - retry.lastMs > kTransientRejectionRetryMs) {
    retry.pending = true;
    retry.sinceMs = nowMs;
  }
  retry.lastMs = nowMs;
  if (nowMs - retry.sinceMs < kTransientRejectionRetryMs) return true;
  retry.pending = false;
  return false;
}

void clearTransientRejection(TransientRejectionRetry& retry) {
  retry.pending = false;
}

// The program is over. Outputs stop immediately. The recording layer may keep
// capturing its passive fan-off decay tail independently of actuation.
bool finishRoast(uint32_t nowUs, const char* endReason) {
  markRoastEnded(endReason);
  actuator.stop(nowUs);
  roastCommandHeatMilli = 0;
  roastCommandFanMilli = 0;
  roastCommandHeat = 0.0;
  roastCommandFan = 0.0;
  return finalizeEndedRoastRecordingForStop();
}

bool finalizeEndedRoastRecordingForStop() {
  portENTER_CRITICAL(&thermalLogMux);
  if (!thermalLogUnsaved) {
    portEXIT_CRITICAL(&thermalLogMux);
    return true;
  }
  // Shared Stop can also end a proof or calibration. Those captures retain
  // their passive tail and have not been saved yet, so never acknowledge them
  // as durable merely because this roast-specific finalizer has no work to do.
  if (thermalLogSource != ThermalLogSource::ROAST) {
    portEXIT_CRITICAL(&thermalLogMux);
    return false;
  }
  // Timed and journey programs intentionally keep their passive-decay tail;
  // the Stop acknowledgement must describe that archive as pending.
  if (roastMode != RoastMode::MANUAL) {
    portEXIT_CRITICAL(&thermalLogMux);
    return false;
  }
  // Stop is the complete capture boundary for an operator-steered roast. Close
  // it immediately; the controller archive service performs the flash commit
  // after this timing-sensitive command returns. Until that succeeds, Stop
  // reports the recording as pending and the next-episode gate preserves the
  // RAM recording instead of discarding it.
  thermalLogPassiveTailComplete = true;
  thermalLogActive = false;
  portEXIT_CRITICAL(&thermalLogMux);
  // Durability is acknowledged only after the storage worker commits it.
  return false;
}

// TIMED: explicit steps on exact durations. A Heat step's clock does not start
// until Heat is actually effective, so a step is the dwell that was asked for
// rather than the dwell minus Fan qualification - the same rule calibration
// uses, and the reason a stalled qualification is caught rather than waited out.
void serviceTimedRoast(uint32_t nowUs, const sr800::ActuatorSnapshot& state) {
  roastElapsedSec = (millis() - roastStartedMs) / 1000U;
  const uint32_t stepFan = roastStepFanMilli[roastStepIndex];
  const uint32_t stepHeat = roastStepHeatMilli[roastStepIndex];

  if (stepHeat > 0 && state.effectiveHeatMilli > 0 && !roastHeatObserved) {
    roastHeatObserved = true;
    roastStepEndUs = nowUs + roastStepDwellRemainingSec * 1000000U;
    roastStepDeadlineArmed = true;
  }
  if (stepHeat > 0 && !roastHeatObserved &&
      nowUs - roastStepStartedUs > kCalibrationQualifyStallUs) {
    finishRoast(nowUs, "qualification_stalled");
    return;
  }

  const bool stepDone = roastStepDeadlineArmed &&
      static_cast<int32_t>(nowUs - roastStepEndUs) >= 0;
  if (stepDone) {
    const size_t nextIndex = roastStepIndex + 1;
    if (nextIndex >= roastStepCount) {
      roastStepIndex = nextIndex;
      roastHeatObserved = false;
      roastStepDeadlineArmed = false;
      finishRoast(nowUs, "completed");
      return;
    }
    const uint32_t nextFan = roastStepFanMilli[nextIndex];
    const uint32_t nextHeat = roastStepHeatMilli[nextIndex];
    const char* rejection = nullptr;
    if (!actuator.request(nextFan, nextHeat, micros(), rejection,
                          nextHeat > 0 ? kHeaterProofMaximumMs * 1000U : 0)) {
      // A transient refusal leaves the step boundary uncommitted: the previous
      // step's command keeps running and the boundary retries next pass.
      if (retryTransientRejection(roastRejectionRetry, rejection)) return;
      roastStepIndex = nextIndex;
      roastHeatObserved = false;
      roastStepDeadlineArmed = false;
      finishRoast(nowUs, "step_rejected");
      return;
    }
    clearTransientRejection(roastRejectionRetry);
    roastStepIndex = nextIndex;
    roastHeatObserved = false;
    roastStepDeadlineArmed = false;
    roastCommandFanMilli = nextFan;
    roastCommandHeatMilli = nextHeat;
    roastCommandFan = nextFan / 1000.0;
    roastCommandHeat = nextHeat / 1000.0;
    roastStepStartedUs = nowUs;
    roastStepDwellRemainingSec = roastStepSeconds[roastStepIndex];
    roastStepDeadlineArmed = nextHeat == 0;
    roastStepEndUs = roastStepDeadlineArmed
        ? nowUs + roastStepDwellRemainingSec * 1000000U : 0;
    roastLastRenewUs = nowUs;
    return;
  }

  if (stepHeat > 0 && state.effectiveHeatMilli > 0 &&
      nowUs - roastLastRenewUs >= kCalibrationRenewIntervalUs) {
    // Renewing the 30 s lease keeps the zero-cross ISR bound as the authority:
    // a dead loop lets Heat expire hands-off within 30 s, browser or no browser.
    const char* rejection = nullptr;
    if (actuator.request(stepFan, stepHeat, micros(), rejection,
                         kHeaterProofMaximumMs * 1000U)) {
      clearTransientRejection(roastRejectionRetry);
      roastRenewals++;
      roastLastRenewUs = nowUs;
    } else if (!retryTransientRejection(roastRejectionRetry, rejection)) {
      finishRoast(nowUs, "renewal_rejected");
    }
  }
}

// MANUAL ROAST: the operator chooses each instruction, but the controller owns
// its lifetime. The same 30-minute whole-instruction deadline used by the
// diagnostic Manual page bounds both Fan-only and Heat-bearing instructions;
// the actuator's shorter Heat lease remains the independent dead-loop backstop.
void serviceManualRoast(uint32_t nowUs,
                        const sr800::ActuatorSnapshot& state) {
  const uint32_t nowMs = millis();
  roastElapsedSec = (nowMs - roastStartedMs) / 1000U;
  if (sr800::runtime::instructionExpired(
          nowMs, roastLastInstructionMs, kManualInstructionLeaseMs)) {
    finishRoast(nowUs, "instruction_expired");
    return;
  }
  if (roastCommandHeatMilli > 0 && state.effectiveHeatMilli > 0 &&
      nowUs - roastLastRenewUs >= kCalibrationRenewIntervalUs) {
    const char* rejection = nullptr;
    if (actuator.request(roastCommandFanMilli, roastCommandHeatMilli, micros(),
                         rejection, kHeaterProofMaximumMs * 1000U)) {
      clearTransientRejection(roastRejectionRetry);
      roastRenewals++;
      roastLastRenewUs = nowUs;
    } else if (!retryTransientRejection(roastRejectionRetry, rejection)) {
      finishRoast(nowUs, "renewal_rejected");
    }
  }
}

// JOURNEY: one control tick per second through the ported law. Everything about
// what to command lives in `sr800_journey_control.cpp` and is pinned by the
// cross-language vectors; everything here is about turning that answer into a
// leased actuator request and knowing when the roast is over.
void serviceJourneyRoast(uint32_t nowUs, const sr800::ActuatorSnapshot& state,
                         bool forceTick = false) {
  const uint32_t nowMs = millis();
  if (!forceTick && nowMs - roastLastTickMs < kRoastControlIntervalMs) return;
  roastLastTickMs = nowMs;

  const double elapsedSec = (nowMs - roastStartedMs) / 1000.0;
  roastElapsedSec = static_cast<uint32_t>(elapsedSec);

  // What counts as a measurement. Anything else is a holdover, not a zero.
  const bool sampleValid = thermocoupleFreshValid(nowMs, kRoastSampleFreshnessMs);

  sr800::JourneyStepInput input;
  input.plan.zones = roastZones;
  input.plan.zoneCount = roastZoneCount;
  input.elapsedSec = elapsedSec;
  input.beanTempC = sampleValid ? static_cast<double>(maxThermocoupleC) : NAN;
  input.ambientC = roastAmbientC;
  input.batchMassG = roastBatchMassG;
  input.calibration = roastCalibration;

  const sr800::JourneyStepResult step =
      sr800::journeyControlStep(roastControlState, input);
  roastControlState = step.state;
  roastTargetC = step.command.goalC;
  roastCorrectionTotal = step.correction.totalRatePerMin;
  roastIntegral = step.correction.integralRatePerMin;
  roastHoldover = step.correction.holdover;
  roastSaturated = step.correction.saturated;
  roastCommandFan = step.command.fan;
  roastCommandHeat = step.command.heat;

  // A zone the anchor has left was attained at this tick. The loop covers an
  // overshoot that cleared several endpoints at once, which the control law
  // explicitly allows.
  if (step.zoneAdvanced) {
    const uint16_t attainedAt = elapsedSec >= kRoastZoneNotAttained
        ? static_cast<uint16_t>(kRoastZoneNotAttained - 1)
        : static_cast<uint16_t>(elapsedSec);
    for (size_t index = 0; index < step.zoneIndex &&
                           index < sr800::kMaxJourneyZones; ++index) {
      if (roastZoneAttainedSec[index] == kRoastZoneNotAttained) {
        roastZoneAttainedSec[index] = attainedAt;
      }
    }
  }

  // A dropout is survivable for a while - the step runs feed-forward against
  // the plan with the integral frozen - and then it is simply a lost probe.
  if (roastHeatContinuity.sensorLost(
          step.correction.holdover, nowMs, kRoastHoldoverLimitMs)) {
    // End the roast immediately rather than leaving an unwatched heater
    // running out its remaining lease.
    finishRoast(nowUs, "sensor_lost");
    return;
  }

  // The journey is done when the FINAL zone is attained. A trailing cooling
  // zone is attained by falling to its endpoint, so this covers it too.
  if (step.zoneIndex + 1 >= roastZoneCount && step.zoneCompleted) {
    if (step.zoneIndex < sr800::kMaxJourneyZones &&
        roastZoneAttainedSec[step.zoneIndex] == kRoastZoneNotAttained) {
      roastZoneAttainedSec[step.zoneIndex] = elapsedSec >= kRoastZoneNotAttained
          ? static_cast<uint16_t>(kRoastZoneNotAttained - 1)
          : static_cast<uint16_t>(elapsedSec);
    }
    finishRoast(nowUs, "completed");
    return;
  }

  const uint32_t heatMilli = roastLevelToMilli(step.command.heat);
  // The control law already folds the heat-on Fan 1.0 rule into its solve;
  // this executor-level lift keeps the invariant unconditional at the request.
  const uint32_t fanMilli =
      heatOnFanFloorMilli(roastLevelToMilli(step.command.fan), heatMilli);
  const char* rejection = nullptr;
  if (actuator.request(fanMilli, heatMilli, micros(), rejection,
                       heatMilli > 0 ? kHeaterProofMaximumMs * 1000U : 0)) {
    clearTransientRejection(roastRejectionRetry);
    const sr800::ActuatorSnapshot accepted = actuator.snapshot(nowUs);
    roastHeatObserved = heatMilli == 0 || accepted.effectiveHeatMilli > 0;
    roastCommandFanMilli = fanMilli;
    roastCommandHeatMilli = heatMilli;
    roastLastRenewUs = nowUs;
    if (heatMilli > 0) roastRenewals++;
  } else if (!step.correction.holdover &&
             !retryTransientRejection(roastRejectionRetry, rejection)) {
    // A zero-cross gap the actuator is still riding through (or a one-sample
    // thermal UNKNOWN) skips this tick and keeps the previous command; the
    // actuator's own grace and fault latch decide whether it is a real loss.
    finishRoast(nowUs, "command_rejected");
    return;
  }
  // Under holdover a rejected Heat request is expected rather than exceptional:
  // the actuator's own thermal gate is refusing Heat for the same reason the
  // step is running blind. The standing lease expires on its own and the
  // holdover budget above decides when the roast is over.

  // Heat that is asked for but never becomes effective is a stalled Fan
  // qualification, not a slow roast. Thermal holdover owns sensor-gated Heat.
  if (roastHeatContinuity.qualificationStalled(
          state.thermalSafetyStatus == sr800::ThermalSafetyStatus::HEALTHY,
          step.correction.holdover, heatMilli > 0,
          state.effectiveHeatMilli > 0, nowMs,
          kCalibrationQualifyStallUs / 1000U)) {
    finishRoast(nowUs, "qualification_stalled");
  }
}
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
void loop() {
  const uint32_t loopEntryMs = millis();
  if (lastLoopEntryMs != 0) {
    lastLoopGapMs = loopEntryMs - lastLoopEntryMs;
    maximumLoopGapMs = std::max(maximumLoopGapMs, lastLoopGapMs);
  }
  lastLoopEntryMs = loopEntryMs;
  sampleMax31856();
  serviceThermalCaptureLifecycle(loopEntryMs);
  serviceNetworkCommandMailbox();
  serviceOtaRestart();
  serviceDiagnosticTests(micros());
  publishNetworkSnapshot();
  maintainStationConnection();
  const bool networkReady = WiFi.status() == WL_CONNECTED || apActive;
  if (networkReady &&
      !sr800::network::httpServerRunning() &&
      loopEntryMs - lastHttpServerStartAttemptMs >= kHttpServerRetryIntervalMs) {
    lastHttpServerStartAttemptMs = loopEntryMs;
    if (startCrackleHttpServer()) {
      Serial.println("Native HTTP service started");
    } else {
      Serial.printf("FAULT: native HTTP service retry failed: %s\n",
                    sr800::network::httpServerStartFailure());
    }
  }
  serviceOtaAdmission();
  // OTA metadata belongs to one task at a time. The raw uploader validates the
  // currently running image before esp_ota_begin; loop validation resumes only
  // after a denied or failed admission has been released.
  if (!otaReservesPort80()) maybeValidateOtaImage();
  delay(1);
}
