triwebb1/crackle/firmware/crackle/tests/log_codec_test.cpp

// Host verification of the recording codec: the frame layout that decides what
// an archived roast actually costs on the 896 KB volume, and what precision it
// keeps once it is there.
//
// The load-bearing claim is the round trip. Storage rounds a measured
// temperature to a TENTH of a degree on purpose, so "lossless" is not the
// property to test - idempotence is: quantize once and the bytes carry that
// value forever, decode gives it back exactly, and re-encoding what was decoded
// reproduces the payload byte for byte. Everything else here defends that:
// missing readings survive as missing, a corrupt frame stops the stream instead
// of poisoning the samples after it, and a truncated file is refused rather
// than served short.
//
// `testDecayTailResolution` is the reason the unit is tenths rather than whole
// degrees, stated as an assertion: a passive decay of 0.1 C/s must come back as
// a curve, not as a staircase of ten-second flats, because that tail is what
// the loss and tau coefficients are fitted from.
//
// The compression measurement runs a synthetic 25-minute roast rather than a
// contrived best case, because the number in the README is a capacity promise.

#include <algorithm>
#include <cmath>
#include <cstdint>
#include <cstdio>
#include <cstring>
#include <iostream>
#include <string>
#include <vector>

#include "sr800_log_codec.h"

namespace {

using sr800::logcodec::Decoder;
using sr800::logcodec::DecodeStatus;
using sr800::logcodec::Encoder;
using sr800::logcodec::RawSample;
using sr800::logcodec::Sample;

int failures = 0;

void require(bool condition, const char* message) {
  if (!condition) {
    std::cerr << "FAIL: " << message << '\n';
    failures++;
  }
}

std::vector<uint8_t> encodeAll(const std::vector<RawSample>& samples) {
  Encoder encoder;
  sr800::logcodec::encodeBegin(encoder);
  std::vector<uint8_t> payload;
  uint8_t frame[sr800::logcodec::kMaxEncodedSampleBytes];
  for (const RawSample& raw : samples) {
    const size_t written =
        sr800::logcodec::encodeRawSample(encoder, raw, frame);
    require(written <= sizeof(frame), "a frame stayed inside the worst case");
    payload.insert(payload.end(), frame, frame + written);
  }
  return payload;
}

// Decodes exactly `count` samples, one at a time, through a deliberately mean
// feed: the decoder is handed one more byte at a time than it had before, so
// every NEED_MORE boundary in the format is exercised rather than assumed.
bool decodeAllDribbled(const std::vector<uint8_t>& payload, size_t count,
                       std::vector<Sample>& out) {
  Decoder decoder;
  sr800::logcodec::decodeBegin(decoder);
  out.clear();
  size_t offset = 0;
  size_t visible = 0;
  while (out.size() < count) {
    Sample sample = {};
    size_t consumed = 0;
    const DecodeStatus status = sr800::logcodec::decodeSample(
        decoder, payload.data() + offset, visible, consumed, sample);
    if (status == DecodeStatus::OK) {
      offset += consumed;
      visible -= consumed;
      out.push_back(sample);
      continue;
    }
    if (status == DecodeStatus::MALFORMED) return false;
    if (offset + visible >= payload.size()) return false;  // truncated
    visible++;
  }
  return true;
}

bool sameSample(const Sample& a, const Sample& b) {
  if (a.tMs != b.tMs) return false;
  if (a.thermocoupleValid != b.thermocoupleValid) return false;
  if (a.coldJunctionValid != b.coldJunctionValid) return false;
  if (a.thermocoupleValid && a.thermocoupleDeci != b.thermocoupleDeci) {
    return false;
  }
  if (a.coldJunctionValid && a.coldJunctionDeci != b.coldJunctionDeci) {
    return false;
  }
  return a.fanDeci == b.fanDeci && a.heatDeci == b.heatDeci;
}

RawSample makeSample(uint32_t tMs, int16_t tcCenti, int16_t cjCenti,
                     uint16_t fanMilli, uint16_t heatMilli) {
  RawSample raw = {};
  raw.tMs = tMs;
  raw.thermocoupleCenti = tcCenti;
  raw.coldJunctionCenti = cjCenti;
  raw.fanMilli = fanMilli;
  raw.heatMilli = heatMilli;
  return raw;
}

// --- the rounding rule itself -------------------------------------------

void testQuantization() {
  require(sr800::logcodec::centiToDeciDegrees(0) == 0, "0.00 C rounds to 0");
  require(sr800::logcodec::centiToDeciDegrees(4999) == 500, "49.99 -> 50.0");
  require(sr800::logcodec::centiToDeciDegrees(1855) == 186,
          "half rounds away from zero, upward");
  require(sr800::logcodec::centiToDeciDegrees(-1855) == -186,
          "half rounds away from zero, downward");
  require(sr800::logcodec::centiToDeciDegrees(1854) == 185, "18.54 -> 18.5");
  require(sr800::logcodec::centiToDeciDegrees(-1854) == -185,
          "-18.54 -> -18.5");
  require(sr800::logcodec::centiToDeciDegrees(32767) == 3277,
          "the top of the centi range still fits a deci-degree int16");
  require(sr800::logcodec::centiToDeciDegrees(-32767) == -3277,
          "the bottom of the centi range does too");
  // The whole point of the revision: a tenth of a degree is representable, so
  // consecutive readings a tenth apart stay distinct instead of collapsing.
  require(sr800::logcodec::centiToDeciDegrees(18740) !=
              sr800::logcodec::centiToDeciDegrees(18750),
          "187.4 and 187.5 are different stored values");

  require(sr800::logcodec::milliToDeci(0) == 0, "fan off is 0 deci");
  require(sr800::logcodec::milliToDeci(5000) == 50, "level 5.0 is 50 deci");
  require(sr800::logcodec::milliToDeci(10000) == 100, "level 10.0 is 100 deci");
  require(sr800::logcodec::milliToDeci(3300) == 33,
          "every commandable 0.1 step is exact");
  require(sr800::logcodec::milliToDeci(3350) == 34,
          "an off-grid value rounds half away from zero");
  require(sr800::logcodec::milliToDeci(65535) == 655,
          "the deci ceiling matches the uint16 milli ceiling");

  // Quantization must be idempotent, or "encode(decode(x)) == decode(encode(x))"
  // would be a claim about one round only.
  const RawSample raw = makeSample(1234, 18763, 2649, 7350, 4425);
  const Sample once = sr800::logcodec::quantize(raw);
  RawSample requantized = raw;
  requantized.thermocoupleCenti =
      static_cast<int16_t>(once.thermocoupleDeci * 10);
  requantized.coldJunctionCenti =
      static_cast<int16_t>(once.coldJunctionDeci * 10);
  requantized.fanMilli = static_cast<uint16_t>(once.fanDeci * 100);
  requantized.heatMilli = static_cast<uint16_t>(once.heatDeci * 100);
  require(sameSample(once, sr800::logcodec::quantize(requantized)),
          "quantizing an already-quantized sample changes nothing");
  // The controller's safety latch is 400 C. The in-flight log must therefore
  // retain every plausible pre-latch value instead of wrapping at 327.68 C.
  Sample high = {};
  high.tMs = 1000;
  high.thermocoupleValid = true;
  high.coldJunctionValid = true;
  high.thermocoupleDeci = 3999;
  high.coldJunctionDeci = 250;
  high.fanDeci = 100;
  high.heatDeci = 100;
  Encoder highEncoder;
  sr800::logcodec::encodeBegin(highEncoder);
  uint8_t highFrame[sr800::logcodec::kMaxEncodedSampleBytes];
  const size_t highBytes = sr800::logcodec::encodeSample(
      highEncoder, high, highFrame);
  Decoder highDecoder;
  sr800::logcodec::decodeBegin(highDecoder);
  Sample highDecoded = {};
  size_t highConsumed = 0;
  require(sr800::logcodec::decodeSample(
              highDecoder, highFrame, highBytes, highConsumed, highDecoded) ==
              DecodeStatus::OK &&
              highConsumed == highBytes && highDecoded.thermocoupleDeci == 3999,
          "399.9 C survives the v4 recording codec without int16 centi wrap");
}

// --- exact round trip ----------------------------------------------------

void testRoundTrip() {
  std::vector<RawSample> samples;
  // First sample carries absolutes on every channel, and a non-zero start time.
  samples.push_back(makeSample(500, 2438, 2210, 5000, 0));
  // A long constant stretch: the case the delta framing exists for.
  for (int index = 1; index <= 400; ++index) {
    samples.push_back(makeSample(500 + 1000u * index, 2438, 2210, 5000, 0));
  }
  // Level changes, both directions, including a jump to the ceiling.
  samples.push_back(makeSample(401500, 3000, 2215, 10000, 9000));
  samples.push_back(makeSample(402500, 4550, 2220, 100, 100));
  samples.push_back(makeSample(403500, 4550, 2220, 65535, 65535));
  samples.push_back(makeSample(404500, 4550, 2220, 0, 0));
  // A dropout: the thermocouple went missing while the cold junction did not.
  samples.push_back(makeSample(405500, sr800::logcodec::kMissingCenti, 2225,
                               5000, 3000));
  samples.push_back(makeSample(406500, sr800::logcodec::kMissingCenti, 2225,
                               5000, 3000));
  // Both missing at once, then a return: the predictor must have stood still.
  samples.push_back(makeSample(407500, sr800::logcodec::kMissingCenti,
                               sr800::logcodec::kMissingCenti, 5000, 3000));
  samples.push_back(makeSample(408500, 4551, 2226, 5000, 3000));
  // A negative reading, and one either side of the rounding boundary - which
  // for tenths sits at the half-CENTI, not the half-degree.
  samples.push_back(makeSample(409500, -455, -1244, 5000, 3000));
  samples.push_back(makeSample(410500, 1245, 1244, 5000, 3000));
  // A time gap far larger than the nominal interval.
  samples.push_back(makeSample(999999, 2000, 2000, 0, 0));

  const std::vector<uint8_t> payload = encodeAll(samples);
  std::vector<Sample> decoded;
  require(decodeAllDribbled(payload, samples.size(), decoded),
          "the whole stream decoded through a byte-at-a-time feed");
  require(decoded.size() == samples.size(), "every sample came back");

  bool exact = true;
  for (size_t index = 0; index < decoded.size() && index < samples.size();
       ++index) {
    if (!sameSample(decoded[index], sr800::logcodec::quantize(samples[index]))) {
      exact = false;
      std::cerr << "  sample " << index << " differs from its quantized form\n";
    }
  }
  require(exact, "decode(encode(x)) equals quantize(x) for every sample");

  // The dropout must not have moved the temperature predictor: 45.50 stores as
  // 455 before it and 45.51 stores as 455 after, so the returning sample is a
  // zero delta against a reading three samples earlier.
  if (decoded.size() == samples.size()) {
    require(decoded[405].thermocoupleValid == false,
            "a missing thermocouple decodes as missing, not as a substitute");
    require(decoded[405].coldJunctionValid &&
                decoded[405].coldJunctionDeci == 223,
            "one channel can go missing while the other keeps reporting");
    require(decoded[407].thermocoupleValid == false &&
                decoded[407].coldJunctionValid == false,
            "both channels can be missing in the same sample");
    require(decoded[408].thermocoupleValid &&
                decoded[408].thermocoupleDeci == 455,
            "the reading after a dropout is relative to the last real one");
    require(decoded[409].thermocoupleDeci == -46 &&
                decoded[409].coldJunctionDeci == -124,
            "negative readings round away from zero, not toward it");
    require(decoded[410].thermocoupleDeci == 125 &&
                decoded[410].coldJunctionDeci == 124,
            "the rounding boundary falls where the tenths rule says");
    require(decoded[411].tMs == 999999,
            "a time gap far off the nominal interval survives exactly");
  }

  // And the other direction: re-encoding what came out must reproduce the bytes.
  Encoder encoder;
  sr800::logcodec::encodeBegin(encoder);
  std::vector<uint8_t> reencoded;
  uint8_t frame[sr800::logcodec::kMaxEncodedSampleBytes];
  for (const Sample& sample : decoded) {
    const size_t written =
        sr800::logcodec::encodeSample(encoder, sample, frame);
    reencoded.insert(reencoded.end(), frame, frame + written);
  }
  require(reencoded.size() == payload.size() &&
              std::memcmp(reencoded.data(), payload.data(), payload.size()) == 0,
          "encode(decode(payload)) reproduces the payload byte for byte");
}

// --- the frame layout, byte by byte -------------------------------------

void testFrameLayout() {
  Encoder encoder;
  sr800::logcodec::encodeBegin(encoder);
  uint8_t frame[sr800::logcodec::kMaxEncodedSampleBytes];

  // t=0, tc=0 C, cj=0 C, fan=0, heat=0: every channel is its own zero, so the
  // first frame is the five cheapest tokens the format can produce.
  const size_t first = sr800::logcodec::encodeRawSample(
      encoder, makeSample(0, 0, 0, 0, 0), frame);
  require(first == 5, "an all-zero first sample costs exactly five bytes");
  require(frame[0] == 0x00, "time zigzag(0) is 0x00");
  require(frame[1] == 0x01, "a present temperature of delta 0 is token 1");
  require(frame[2] == 0x01, "the cold junction uses the same escape offset");
  require(frame[3] == 0x00 && frame[4] == 0x00, "levels use no offset");

  // The first 1 Hz step is the only place the interval is spelled out: the
  // previous interval was 0, so the residual is the whole 1000 ms.
  const size_t second = sr800::logcodec::encodeRawSample(
      encoder, makeSample(1000, 0, 0, 0, 0), frame);
  require(second == 6, "the first interval of a recording costs six bytes");
  require(frame[0] == 0xD0 && frame[1] == 0x0F,
          "zigzag(1000) = 2000 encodes as D0 0F");

  // From there a steady interval is free: this is the 5 bytes/sample the
  // capacity math rests on.
  const size_t third = sr800::logcodec::encodeRawSample(
      encoder, makeSample(2000, 0, 0, 0, 0), frame);
  require(third == 5, "a steady 1 Hz sample costs exactly five bytes");
  require(frame[0] == 0x00, "an unchanged interval is the single byte 0x00");

  // Scheduling jitter must stay inside one byte, or the steady state is a lie.
  const size_t jittered = sr800::logcodec::encodeRawSample(
      encoder, makeSample(3004, 0, 0, 0, 0), frame);
  require(jittered == 5, "a 4 ms interval wobble still costs five bytes");

  // The missing escape is token 0 and is one byte, whatever the last reading was.
  const size_t dropout = sr800::logcodec::encodeRawSample(
      encoder,
      makeSample(4008, sr800::logcodec::kMissingCenti,
                 sr800::logcodec::kMissingCenti, 0, 0),
      frame);
  require(dropout == 5, "a dropout costs no more than a reading");
  require(frame[1] == 0x00 && frame[2] == 0x00,
          "a missing channel is the single byte 0x00");

  // Tenths have to be free, or they would not be worth having. A varint token
  // stays one byte for any zigzagged delta below 128, so a temperature channel
  // costs one byte for every step up to +/-63 deci - 6.3 C between consecutive
  // samples, which nothing thermal in this machine does.
  sr800::logcodec::Encoder walker;
  sr800::logcodec::encodeBegin(walker);
  // Two samples to settle the time predictor, so what follows measures the
  // temperature channel and nothing else.
  sr800::logcodec::encodeRawSample(walker, makeSample(0, 2000, 2000, 0, 0),
                                   frame);
  sr800::logcodec::encodeRawSample(walker, makeSample(1000, 2000, 2000, 0, 0),
                                   frame);
  const size_t tenth = sr800::logcodec::encodeRawSample(
      walker, makeSample(2000, 2010, 2000, 0, 0), frame);
  require(tenth == 5, "a 0.1 C step costs exactly five bytes, like no step");
  const size_t bigStep = sr800::logcodec::encodeRawSample(
      walker, makeSample(3000, 2640, 2000, 0, 0), frame);
  require(bigStep == 5,
          "a 6.3 C move in one second is still one byte of temperature");
  const size_t hugeStep = sr800::logcodec::encodeRawSample(
      walker, makeSample(4000, 3290, 2000, 0, 0), frame);
  require(hugeStep == 6,
          "only a move past 6.3 C/s spends a second byte on temperature");
}

// --- the passive decay tail, which is why the unit is tenths ---------------

// A 0.1 C/s decay is the shape the loss and tau fit is regressed from. Stored
// as whole degrees it is not a decay at all: it is a staircase of ten-second
// flats, and 90% of the samples in it carry no information. This test asserts
// the property that failure would violate - every sample distinguishable from
// the one before it - rather than asserting the unit.
void testDecayTailResolution() {
  constexpr int kTailSeconds = 180;  // the recorded tail, at its new length
  std::vector<RawSample> samples;
  for (int second = 0; second < kTailSeconds; ++second) {
    // 120.00 C falling exactly 0.1 C per second, fan and heat off.
    const int16_t centi = static_cast<int16_t>(12000 - 10 * second);
    samples.push_back(makeSample(1000u * second, centi, 2500, 0, 0));
  }

  const std::vector<uint8_t> payload = encodeAll(samples);
  std::vector<Sample> decoded;
  require(decodeAllDribbled(payload, samples.size(), decoded),
          "the decay tail decodes completely");
  require(decoded.size() == samples.size(), "every tail sample came back");

  // No flats. Consecutive samples must differ by exactly one deci-degree.
  bool strictlyFalling = decoded.size() == samples.size();
  int distinct = decoded.empty() ? 0 : 1;
  for (size_t index = 1; index < decoded.size(); ++index) {
    const int step =
        decoded[index].thermocoupleDeci - decoded[index - 1].thermocoupleDeci;
    if (step != -1) strictlyFalling = false;
    if (step != 0) distinct++;
  }
  require(strictlyFalling,
          "a 0.1 C/s decay falls by one stored unit every single second");
  require(distinct == kTailSeconds,
          "the tail reconstructs as 180 distinct points, not 18 flats");

  // And the resolution is not paid for: every steady frame is the same five
  // bytes whole degrees would have cost. Frame 0 carries three absolute values
  // (7 bytes) and frame 1 spells out the opening 1000 ms interval (6); from
  // there the tail is flat at five, one deci-degree of decay per byte.
  require(payload.size() == static_cast<size_t>(7 + 6 + 5 * (kTailSeconds - 2)),
          "a tenth-degree decay costs the steady five bytes a sample");

  // The reconstructed curve must be the measured one to within the stored
  // quantum, because the fit reads these numbers directly.
  bool withinQuantum = true;
  for (size_t index = 0; index < decoded.size(); ++index) {
    const double stored = decoded[index].thermocoupleDeci / 10.0;
    const double measured = samples[index].thermocoupleCenti / 100.0;
    if (std::fabs(stored - measured) > 0.05) withinQuantum = false;
  }
  require(withinQuantum,
          "every stored point is within half a tenth of what was measured");
}

// --- corruption and truncation ------------------------------------------

void testCrcDetectsCorruption() {
  std::vector<RawSample> samples;
  for (int index = 0; index < 200; ++index) {
    samples.push_back(makeSample(1000u * index,
                                 static_cast<int16_t>(2500 + index * 40),
                                 2300, 6000, 4000));
  }
  const std::vector<uint8_t> payload = encodeAll(samples);
  const uint32_t crc = sr800::logcodec::crc32Finish(sr800::logcodec::crc32Update(
      sr800::logcodec::kCrc32Init, payload.data(), payload.size()));

  // A known-answer check, so the stored checksum is the standard one and a file
  // written by this image stays verifiable by anything that speaks CRC-32.
  const uint8_t reference[] = {'1', '2', '3', '4', '5',
                               '6', '7', '8', '9'};
  const uint32_t referenceCrc =
      sr800::logcodec::crc32Finish(sr800::logcodec::crc32Update(
          sr800::logcodec::kCrc32Init, reference, sizeof(reference)));
  require(referenceCrc == 0xCBF43926u,
          "CRC32 of \"123456789\" is the IEEE check value");

  // Chunked accumulation must equal the one-shot value: the device computes it
  // across 256-byte file reads, never over the whole payload at once.
  uint32_t chunked = sr800::logcodec::kCrc32Init;
  for (size_t offset = 0; offset < payload.size(); offset += 37) {
    const size_t length =
        offset + 37 <= payload.size() ? 37 : payload.size() - offset;
    chunked = sr800::logcodec::crc32Update(chunked, payload.data() + offset,
                                           length);
  }
  require(sr800::logcodec::crc32Finish(chunked) == crc,
          "a chunked CRC equals the one-shot CRC");

  // Every single-byte flip anywhere in the payload must change the checksum.
  bool everyFlipCaught = true;
  for (size_t index = 0; index < payload.size(); index += 7) {
    std::vector<uint8_t> damaged = payload;
    damaged[index] ^= 0x40u;
    const uint32_t damagedCrc =
        sr800::logcodec::crc32Finish(sr800::logcodec::crc32Update(
            sr800::logcodec::kCrc32Init, damaged.data(), damaged.size()));
    if (damagedCrc == crc) everyFlipCaught = false;
  }
  require(everyFlipCaught, "a flipped byte always changes the CRC");
}

void testTruncationRefused() {
  std::vector<RawSample> samples;
  for (int index = 0; index < 50; ++index) {
    samples.push_back(makeSample(1000u * index,
                                 static_cast<int16_t>(2500 + index * 137),
                                 2300, 6000, 4000));
  }
  const std::vector<uint8_t> payload = encodeAll(samples);

  // Cut the payload at every length short of the whole thing. The decoder must
  // never invent the missing tail: it either yields fewer samples than the
  // header promises or says NEED_MORE, and it never reports success for 50.
  bool refusedEverywhere = true;
  for (size_t length = 1; length < payload.size(); ++length) {
    std::vector<uint8_t> cut(payload.begin(), payload.begin() + length);
    std::vector<Sample> decoded;
    if (decodeAllDribbled(cut, samples.size(), decoded)) {
      refusedEverywhere = false;
    }
    if (decoded.size() >= samples.size()) refusedEverywhere = false;
  }
  require(refusedEverywhere,
          "no truncation of the payload ever decodes as a complete recording");

  // A frame cut mid-varint reports NEED_MORE, not MALFORMED: the caller must be
  // able to tell "refill me" from "this file is broken".
  Decoder decoder;
  sr800::logcodec::decodeBegin(decoder);
  Sample sample = {};
  size_t consumed = 0;
  const uint8_t continued[] = {0x80u};  // a varint that never terminates
  require(sr800::logcodec::decodeSample(decoder, continued, sizeof(continued),
                                        consumed, sample) ==
              DecodeStatus::NEED_MORE,
          "an unterminated varint asks for more bytes");
  require(sr800::logcodec::decodeSample(decoder, payload.data(), 0, consumed,
                                        sample) == DecodeStatus::NEED_MORE,
          "an empty slice asks for more bytes");

  // An illegal varint - six continuation bytes - is corruption, not a refill.
  const uint8_t overlong[] = {0x80u, 0x80u, 0x80u, 0x80u, 0x80u, 0x00u};
  sr800::logcodec::decodeBegin(decoder);
  require(sr800::logcodec::decodeSample(decoder, overlong, sizeof(overlong),
                                        consumed, sample) ==
              DecodeStatus::MALFORMED,
          "an over-long varint is refused as corruption");

  // An out-of-domain level: fan deci above the uint16 milli ceiling.
  const uint8_t badLevel[] = {0x00u, 0x01u, 0x01u, 0xFFu, 0xFFu, 0x03u, 0x00u};
  sr800::logcodec::decodeBegin(decoder);
  require(sr800::logcodec::decodeSample(decoder, badLevel, sizeof(badLevel),
                                        consumed, sample) ==
              DecodeStatus::MALFORMED,
          "a level outside the storable domain is refused");
}

// --- the raw layout the v1/v2 payloads still use -------------------------

void testRawSampleLayout() {
  // A v2-shaped payload: the frozen 12-byte little-endian record. The sketch
  // streams v1 and v2 archives through decodeRawSample, so this is the shipped
  // reader, not a parallel one.
  const uint8_t stream[] = {
      // t = 1000 ms, tc = 24.38 C (2438), cj = 22.10 C (2210), fan 5000, heat 0
      0xE8, 0x03, 0x00, 0x00, 0x86, 0x09, 0xA2, 0x08, 0x88, 0x13, 0x00, 0x00,
      // t = 2000 ms, tc missing (INT16_MIN), cj = -12.50 C (-1250), 100, 65535
      0xD0, 0x07, 0x00, 0x00, 0x00, 0x80, 0x1E, 0xFB, 0x64, 0x00, 0xFF, 0xFF};
  RawSample first = {};
  RawSample second = {};
  require(sr800::logcodec::decodeRawSample(stream, sizeof(stream), first),
          "the first raw record parses");
  require(sr800::logcodec::decodeRawSample(
              stream + sr800::logcodec::kRawSampleBytes,
              sizeof(stream) - sr800::logcodec::kRawSampleBytes, second),
          "the second raw record parses");
  require(first.tMs == 1000 && first.thermocoupleCenti == 2438 &&
              first.coldJunctionCenti == 2210 && first.fanMilli == 5000 &&
              first.heatMilli == 0,
          "the v2 record decodes to its stored centi-degrees");
  require(second.tMs == 2000 &&
              second.thermocoupleCenti == sr800::logcodec::kMissingCenti &&
              second.coldJunctionCenti == -1250 && second.fanMilli == 100 &&
              second.heatMilli == 65535,
          "the missing sentinel and a negative reading survive the raw layout");
  require(!sr800::logcodec::decodeRawSample(stream, 11, first),
          "a short raw record is refused rather than read past its end");

  // v1/v2 files keep their centi-degree precision forever: reading one must not
  // quietly apply the archive's rounding rule to data already on disk.
  require(first.thermocoupleCenti == 2438,
          "an archived v2 reading is not re-rounded on the way out");
}

// --- restore validation ----------------------------------------------------
//
// `POST /api/logs/restore` is the only way archive bytes enter the device from
// outside, so this is the only place the archive format is CHECKED rather than
// produced. Every assertion below is a 400 the operator would otherwise not get.

using sr800::logcodec::ArchiveSummary;
using sr800::logcodec::ArchiveVerdict;

constexpr uint32_t kMaxSamples = 4800;  // sr800::volume::kMaxRecordingSamples

void writeU16(std::vector<uint8_t>& out, size_t offset, uint16_t value) {
  out[offset] = static_cast<uint8_t>(value & 0xFFu);
  out[offset + 1] = static_cast<uint8_t>((value >> 8) & 0xFFu);
}

void writeU32(std::vector<uint8_t>& out, size_t offset, uint32_t value) {
  for (size_t index = 0; index < 4; ++index) {
    out[offset + index] = static_cast<uint8_t>((value >> (8 * index)) & 0xFFu);
  }
}
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
