triwebb1/crackle/firmware/crackle/tests/journey_control_vector_test.cpp

// Cross-language verification of the firmware's journey control law.
//
// `sr800_journey_control.cpp` is a hand port of `web/src/domain/journeyControl.ts`. Two
// implementations of the same twenty-minute control law drift silently unless something forces them
// to agree, so the browser is made the ORACLE: `web/scripts/generate-journey-vectors.ts` drives the
// real TypeScript `journeyControlStep` through twelve required scenarios and
// records every input and every
// output, second by second, into `vectors/journey_control_vectors.json`. This test replays all of
// them through the C++ port and requires agreement to 1e-4 on every field of every step.
//
// If this test fails, the PORT is wrong. Regenerating the vector to make it pass converts the
// guarantee into a rubber stamp.
//
// The second half of the file ports the zone-gating behaviours from `journeyControl.zones.test.ts`
// and the integration guards from `journeyControl.pi.test.ts` directly as C++ assertions, because
// those pin down single points that a long replay can pass over.
//
// Build and run from firmware/crackle/tests: `bash run-native-tests.sh` (all suites), or see the
// firmware README for a single-suite command. It reads `vectors/` relative to that directory.
\

#include <cmath>
#include <cstdio>
#include <cstdlib>
#include <fstream>
#include <iostream>
#include <map>
#include <memory>
#include <set>
#include <sstream>
#include <string>
#include <vector>

#include "sr800_journey_control.h"

namespace {

int failures = 0;

void require(bool condition, const std::string& message) {
  if (!condition) {
    std::cerr << "FAIL: " << message << '\n';
    failures += 1;
  }
}

void requireClose(double actual, double expected, double tolerance,
                  const std::string& message) {
  const bool actualNan = std::isnan(actual);
  const bool expectedNan = std::isnan(expected);
  if (actualNan || expectedNan) {
    require(actualNan && expectedNan, message + " (NaN mismatch)");
    return;
  }
  if (std::fabs(actual - expected) > tolerance) {
    std::ostringstream detail;
    detail.precision(12);
    detail << message << ": got " << actual << ", expected " << expected
           << " (delta " << std::fabs(actual - expected) << ")";
    require(false, detail.str());
  }
}
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
