triwebb1/crackle/(commit log)

2026-10-20 Crackle: SR800 roaster controller firmware and web app
    Initial public release, firmware 2026-07-26.127 / web app 0.10.69.
    - ESP32-S3 firmware: hardware-timed fan and heater phase control, device-run
    Timed, Journey, and Manual roasts, a 260 °C overheat limit with a Fan 10
    cooldown, on-device library and recordings, native ESP-IDF network service,
    A/B OTA updates.
    - Preact/TypeScript web app served from the controller, with a full mock
    controller for development. New roasters start with the Espresso Express
    temperature journey and its timed companion.
    - SR800 reverse-engineering notes, wiring diagram, installation guide with a
    parts list, safety policy, and the raw capture eviden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
    [crackle-2026-08-02-manual-roast-log-28.csv, fan-tone-summary.csv, partitions.csv, sr800-capture-1-1-0.4-running.csv, sr800-capture-112.9-blinking-timer.csv, sr800-capture-11C.3-cooling.csv, sr800-capture-993.0.csv, sr800-capture-fan-blink.csv]
2026-10-21 Pin HTML to LF so the embedded bundle builds identically everywhere
    A CRLF checkout of web/index.html carried a carriage return into the
    embedded bundle, so the CI bundle check failed on a Linux checkout.
    .gitattributes now pins *.html to LF and the bundle is regenerated.
2026-10-21 Make the calibration pass-label test timezone-independent
    The expected aria-label hard-coded one local rendering of a UTC
    timestamp, so the test failed on runners in other timezones. It now
    formats the fixture time with formatLocalDateTime, as the label does.
2026-10-28 Fit heating-mode airflow from loaded roasts, not the empty chamber
    Calibration always froze the heating-mode airflow coefficient
    (fanCoolingCPerMinAt10) at the empty-chamber baseline's value. An empty
    chamber measures air cooling bare metal; in a roast the same airflow sets
    how fast heat crosses the bean bed, and recorded Journey roasts that varied
    Fan at a constant Heat put the term at 13-15 °C/min at Fan 10 against the
    chamber's 3. The Journey law inverts this term to choose Fan, so it moved
    Fan about five times harder than the roaster needed: entering a slower
    final zone, a small correction swung Fan across its whole band and the
    bean temperature dipped before recovering.
    fitAgainstBase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
    [crackle.ino]
