triwebb1/crackle/(notices)

Notices in the files:
README.md:
License: PolyForm Noncommercial 1.0.0
